knielsen/pcb_ledtorus_2/(list of files, drawings)

Other design files:
pcb_ledtorus_2.dsn
