knielsen/pcb_ledtorus_2/pcb_ledtorus_2.kicad_pcb

## KiCad design pcb_ledtorus_2.kicad_pcb (2016-04-10)

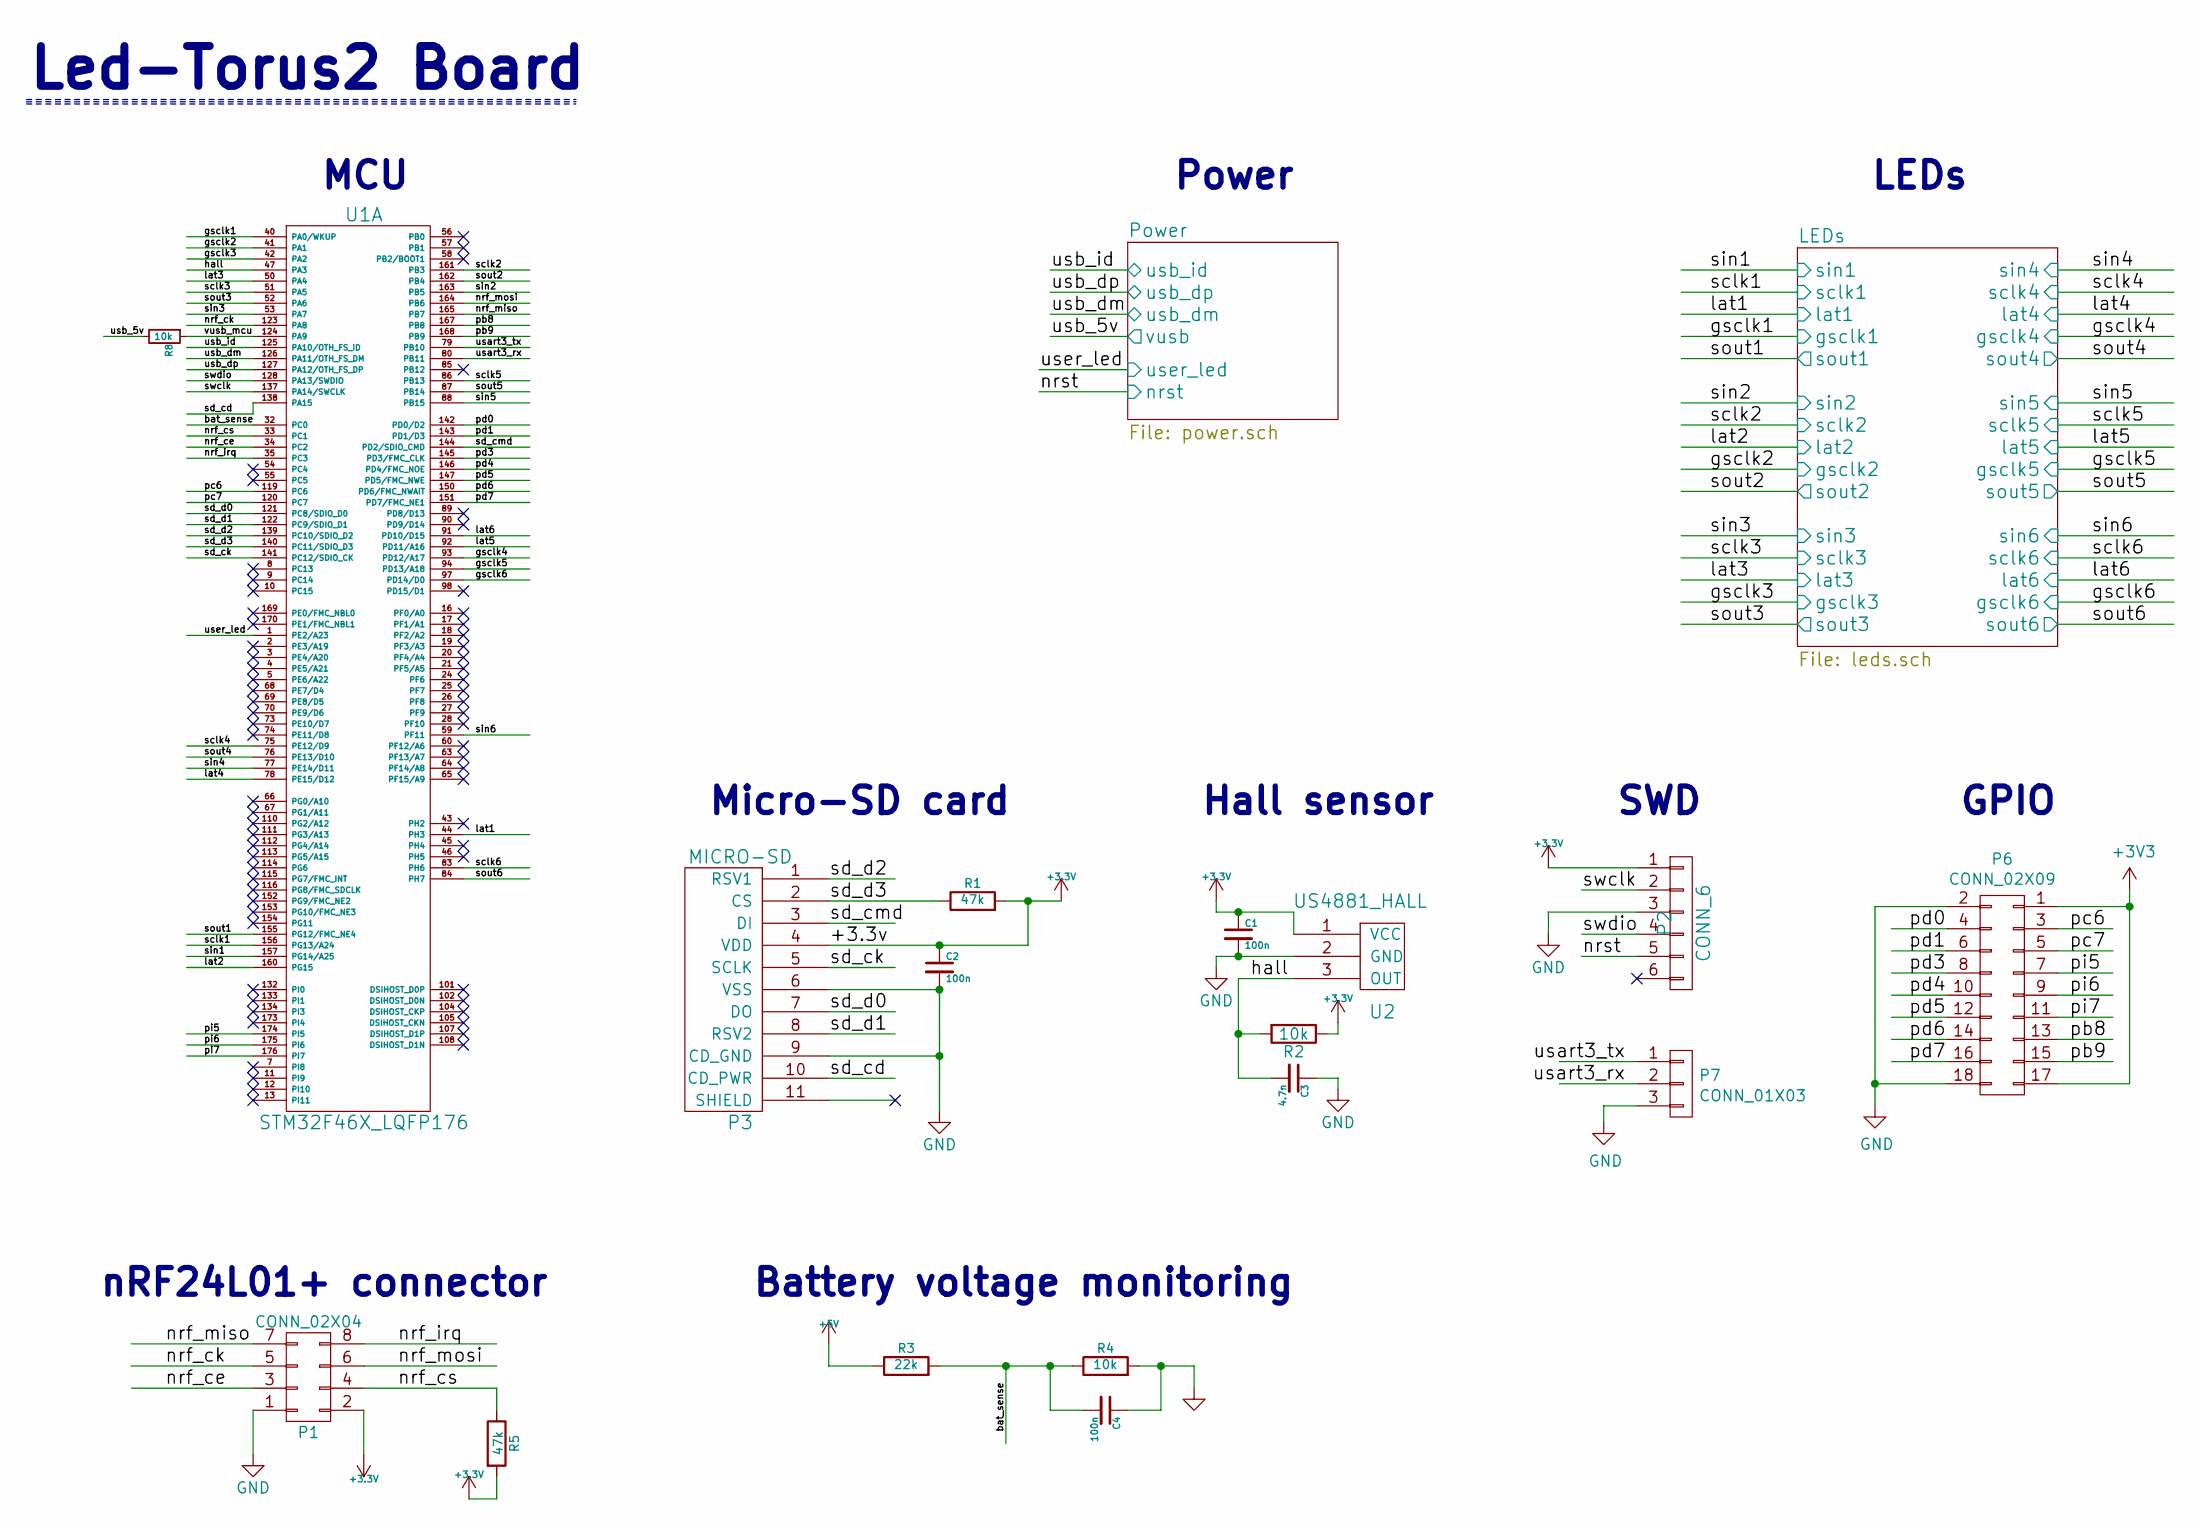
[picture p1: schematic pcb_ledtorus_2.sch]

Parts:
C1, C2, C4: 100n; c_0603
C3: 4.7n; c_0805
P1: CONN_02X04; pin_socket_4x2
P2: CONN_6; pin_strip_6
P3: MICRO-SD; SD_502774
P6: CONN_02X09; Pin_Header_Straight_2x09
P7: CONN_01X03; Pin_Header_Straight_1x03
R1, R5: 47k; r_0805
R2, R4, R8: 10k; r_0805
R3: 22k; r_0805
U1: STM32F46X_LQFP176; LQFP-176
U2: US4881_HALL; TO-92_Inline_Narrow_Oval

Connections:
+5V: R3.1; also elsewhere on the board
/bat_sense: C4.2, R3.2, R4.1, U1.32 (PC0)
/gsclk1: U1.40 (PA0/WKUP); also elsewhere on the board
/gsclk2: U1.41 (PA1); also elsewhere on the board
/gsclk3: U1.42 (PA2); also elsewhere on the board
/gsclk4: U1.93 (PD12/A17); also elsewhere on the board
/gsclk5: U1.94 (PD13/A18); also elsewhere on the board
/gsclk6: U1.97 (PD14/D0); also elsewhere on the board
/hall: C3.2, R2.2, U1.47 (PA3), U2.3 (OUT)
/lat1: U1.44 (PH3); also elsewhere on the board
/lat2: U1.160 (PG15); also elsewhere on the board
/lat3: U1.50 (PA4); also elsewhere on the board
/lat4: U1.78 (PE15/D12); also elsewhere on the board
/lat5: U1.92 (PD11/A16); also elsewhere on the board
/lat6: U1.91 (PD10/D15); also elsewhere on the board
/nrf_ce: P1.3, U1.34 (PC2)
/nrf_ck: P1.5, U1.123 (PA8)
/nrf_cs: P1.4, R5.1, U1.33 (PC1)
/nrf_irq: P1.8, U1.35 (PC3)
/nrf_miso: P1.7, U1.165 (PB7)
/nrf_mosi: P1.6, U1.164 (PB6)
/nrst: P2.5; also elsewhere on the board
/pb8: P6.13, U1.167 (PB8)
/pb9: P6.15, U1.168 (PB9)
/pc6: P6.3, U1.119 (PC6)
/pc7: P6.5, U1.120 (PC7)
/pd0: P6.4, U1.142 (PD0/D2)
/pd1: P6.6, U1.143 (PD1/D3)
/pd3: P6.8, U1.145 (PD3/FMC_CLK)
/pd4: P6.10, U1.146 (PD4/FMC_NOE)
/pd5: P6.12, U1.147 (PD5/FMC_NWE)
/pd6: P6.14, U1.150 (PD6/FMC_NWAIT)
/pd7: P6.16, U1.151 (PD7/FMC_NE1)
/pi5: P6.7, U1.174 (PI5)
/pi6: P6.9, U1.175 (PI6)
/pi7: P6.11, U1.176 (PI7)
/sclk1: U1.156 (PG13/A24); also elsewhere on the board
/sclk2: U1.161 (PB3); also elsewhere on the board
/sclk3: U1.51 (PA5); also elsewhere on the board
/sclk4: U1.75 (PE12/D9); also elsewhere on the board
/sclk5: U1.86 (PB13); also elsewhere on the board
/sclk6: U1.83 (PH6); also elsewhere on the board
/sd_cd: P3.10 (CD_PWR), U1.138 (PA15)
/sd_ck: P3.5 (SCLK), U1.141 (PC12/SDIO_CK)
/sd_cmd: P3.3 (DI), U1.144 (PD2/SDIO_CMD)
/sd_d0: P3.7 (DO), U1.121 (PC8/SDIO_D0)
/sd_d1: P3.8 (RSV2), U1.122 (PC9/SDIO_D1)
/sd_d2: P3.1 (RSV1), U1.139 (PC10/SDIO_D2)
/sd_d3: P3.2 (CS), R1.1, U1.140 (PC11/SDIO_D3)
/sin1: U1.157 (PG14/A25); also elsewhere on the board
/sin2: U1.163 (PB5); also elsewhere on the board
/sin3: U1.53 (PA7); also elsewhere on the board
/sin4: U1.77 (PE14/D11); also elsewhere on the board
/sin5: U1.88 (PB15); also elsewhere on the board
/sin6: U1.59 (PF11); also elsewhere on the board
/sout1: U1.155 (PG12/FMC_NE4); also elsewhere on the board
/sout2: U1.162 (PB4); also elsewhere on the board
/sout3: U1.52 (PA6); also elsewhere on the board
/sout4: U1.76 (PE13/D10); also elsewhere on the board
/sout5: U1.87 (PB14); also elsewhere on the board
/sout6: U1.84 (PH7); also elsewhere on the board
/swclk: P2.2, U1.137 (PA14/SWCLK)
/swdio: P2.4, U1.128 (PA13/SWDIO)
/usart3_rx: P7.2, U1.80 (PB11)
/usart3_tx: P7.1, U1.79 (PB10)
/usb_5v: R8.2; also elsewhere on the board
/usb_dm: U1.126 (PA11/OTH_FS_DM); also elsewhere on the board
/usb_dp: U1.127 (PA12/OTH_FS_DP); also elsewhere on the board
/usb_id: U1.125 (PA10/OTH_FS_ID); also elsewhere on the board
/user_led: U1.1 (PE2/A23); also elsewhere on the board
/vusb_mcu: R8.1, U1.124 (PA9)
GND: C1.2, C2.2, C3.1, C4.1, P1.1, P2.3, P3.6 (VSS), P3.9 (CD_GND), P6.2, P6.18, P7.3, R4.2, U2.2 (GND); also elsewhere on the board

Notes on the sheet:
MCU
Led-Torus2 Board
nRF24L01+ connector
Micro-SD card
Battery voltage monitoring
SWD
Hall sensor
GPIO
Power
LEDs

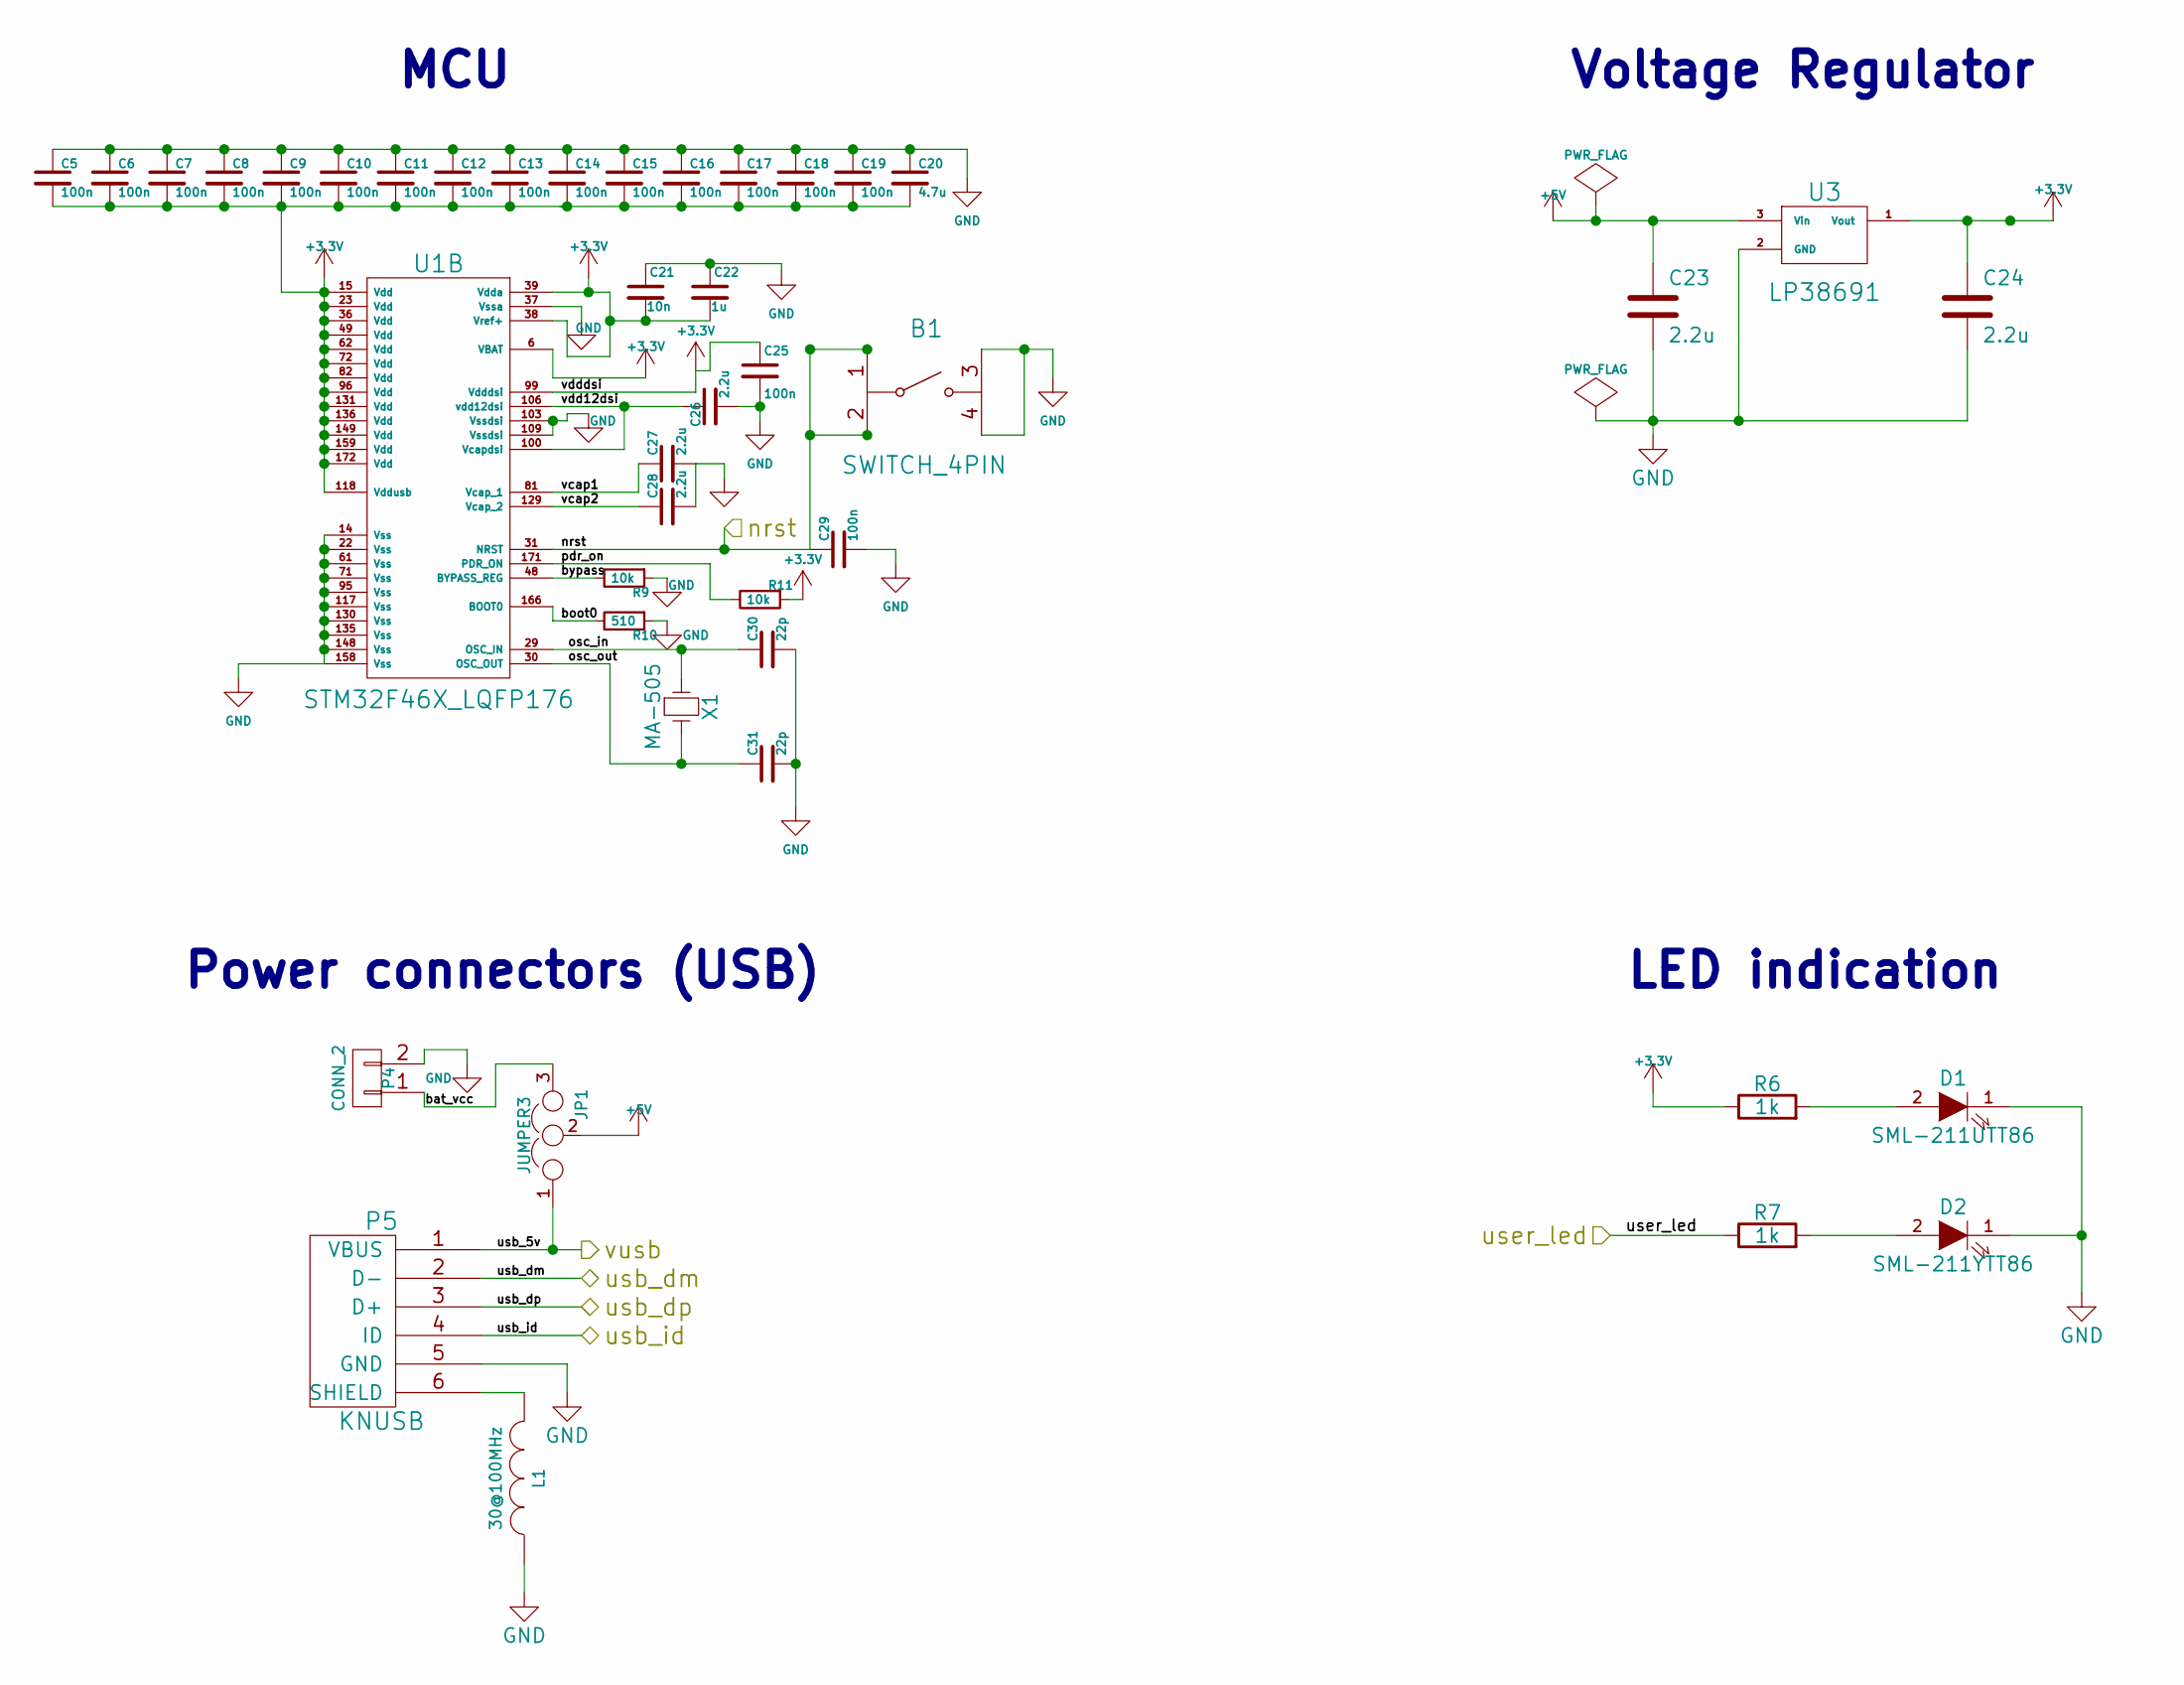
[picture p2: schematic power.sch]

Parts:
B1: SWITCH_4PIN; SWITCH_FSMJSMA
C5, C6, C7, C8, C9, C10, C11, C12, C13, C14, C15, C16, C17, C18, C19, C25, C29: 100n; c_0603
C20: 4.7u; c_0805
C21: 10n; c_0805
C22: 1u; c_0805
C23, C24, C26, C27, C28: 2.2u; c_0805
C30, C31: 22p; c_0805
D1: SML-211UTT86; LED_0805
D2: SML-211YTT86; LED_0805
JP1: JUMPER3; pin_strip_3
L1: 30@100MHz; c_0603
P4: CONN_2; pin_strip_2-90
P5: KNUSB; 10103594-0001LF
R6, R7: 1k; r_0805
R9, R11: 10k; r_0805
R10: 510; r_0805
U1: STM32F46X_LQFP176; LQFP-176
U3: LP38691; TO-252-3
X1: MA-505; 2-SOJ

Connections:
+5V: C23.1, JP1.2, U3.3 (Vin); also elsewhere on the board
/Power/bat_vcc: JP1.3, P4.1
/Power/boot0: R10.2, U1.166 (BOOT0)
/Power/bypass: R9.2, U1.48 (BYPASS_REG)
/Power/osc_in: C30.1, U1.29 (OSC_IN), X1.1
/Power/osc_out: C31.1, U1.30 (OSC_OUT), X1.2
/Power/pdr_on: R11.2, U1.171 (PDR_ON)
/Power/vcap1: C27.1, U1.81 (Vcap_1)
/Power/vcap2: C28.1, U1.129 (Vcap_2)
/Power/vdd12dsi: C26.1, U1.100 (Vcapdsi), U1.106 (vdd12dsi)
/nrst: B1.1, B1.2, C29.1, U1.31 (NRST); also elsewhere on the board
/usb_5v: JP1.1, P5.1 (VBUS); also elsewhere on the board
/usb_dm: P5.2 (D-); also elsewhere on the board
/usb_dp: P5.3 (D+); also elsewhere on the board
/usb_id: P5.4 (ID); also elsewhere on the board
/user_led: R7.1; also elsewhere on the board
GND: B1.3, B1.4, C5.1, C6.1, C7.1, C8.1, C9.1, C10.1, C11.1, C12.1, C13.1, C14.1, C15.1, C16.1, C17.1, C18.1, C19.1, C20.1, C21.1, C22.1, C23.2, C24.2, C25.2, C26.2, C27.2, C28.2, C29.2, C30.2, C31.2, D1.1 (K), D2.1 (K), L1.1, P4.2, P5.5 (GND), R9.1, R10.1, U1.14 (Vss), U1.22 (Vss), U1.37 (Vssa), U1.61 (Vss), U1.71 (Vss), U1.95 (Vss), U1.103 (Vssdsi), U1.109 (Vssdsi), U1.117 (Vss), U1.130 (Vss), U1.135 (Vss), U1.148 (Vss), U1.158 (Vss), U3.2 (GND); also elsewhere on the board
unnamed: D1.2 (A), R6.2
unnamed: D2.2 (A), R7.2
unnamed: L1.2, P5.6 (SHIELD)

Notes on the sheet:
MCU
Voltage Regulator
Power connectors (USB)
LED indication
