knielsen/pcb_ledtorus_2/pcb_ledtorus_2.kicad_pcb

## KiCad design pcb_ledtorus_2.kicad_pcb (continued)

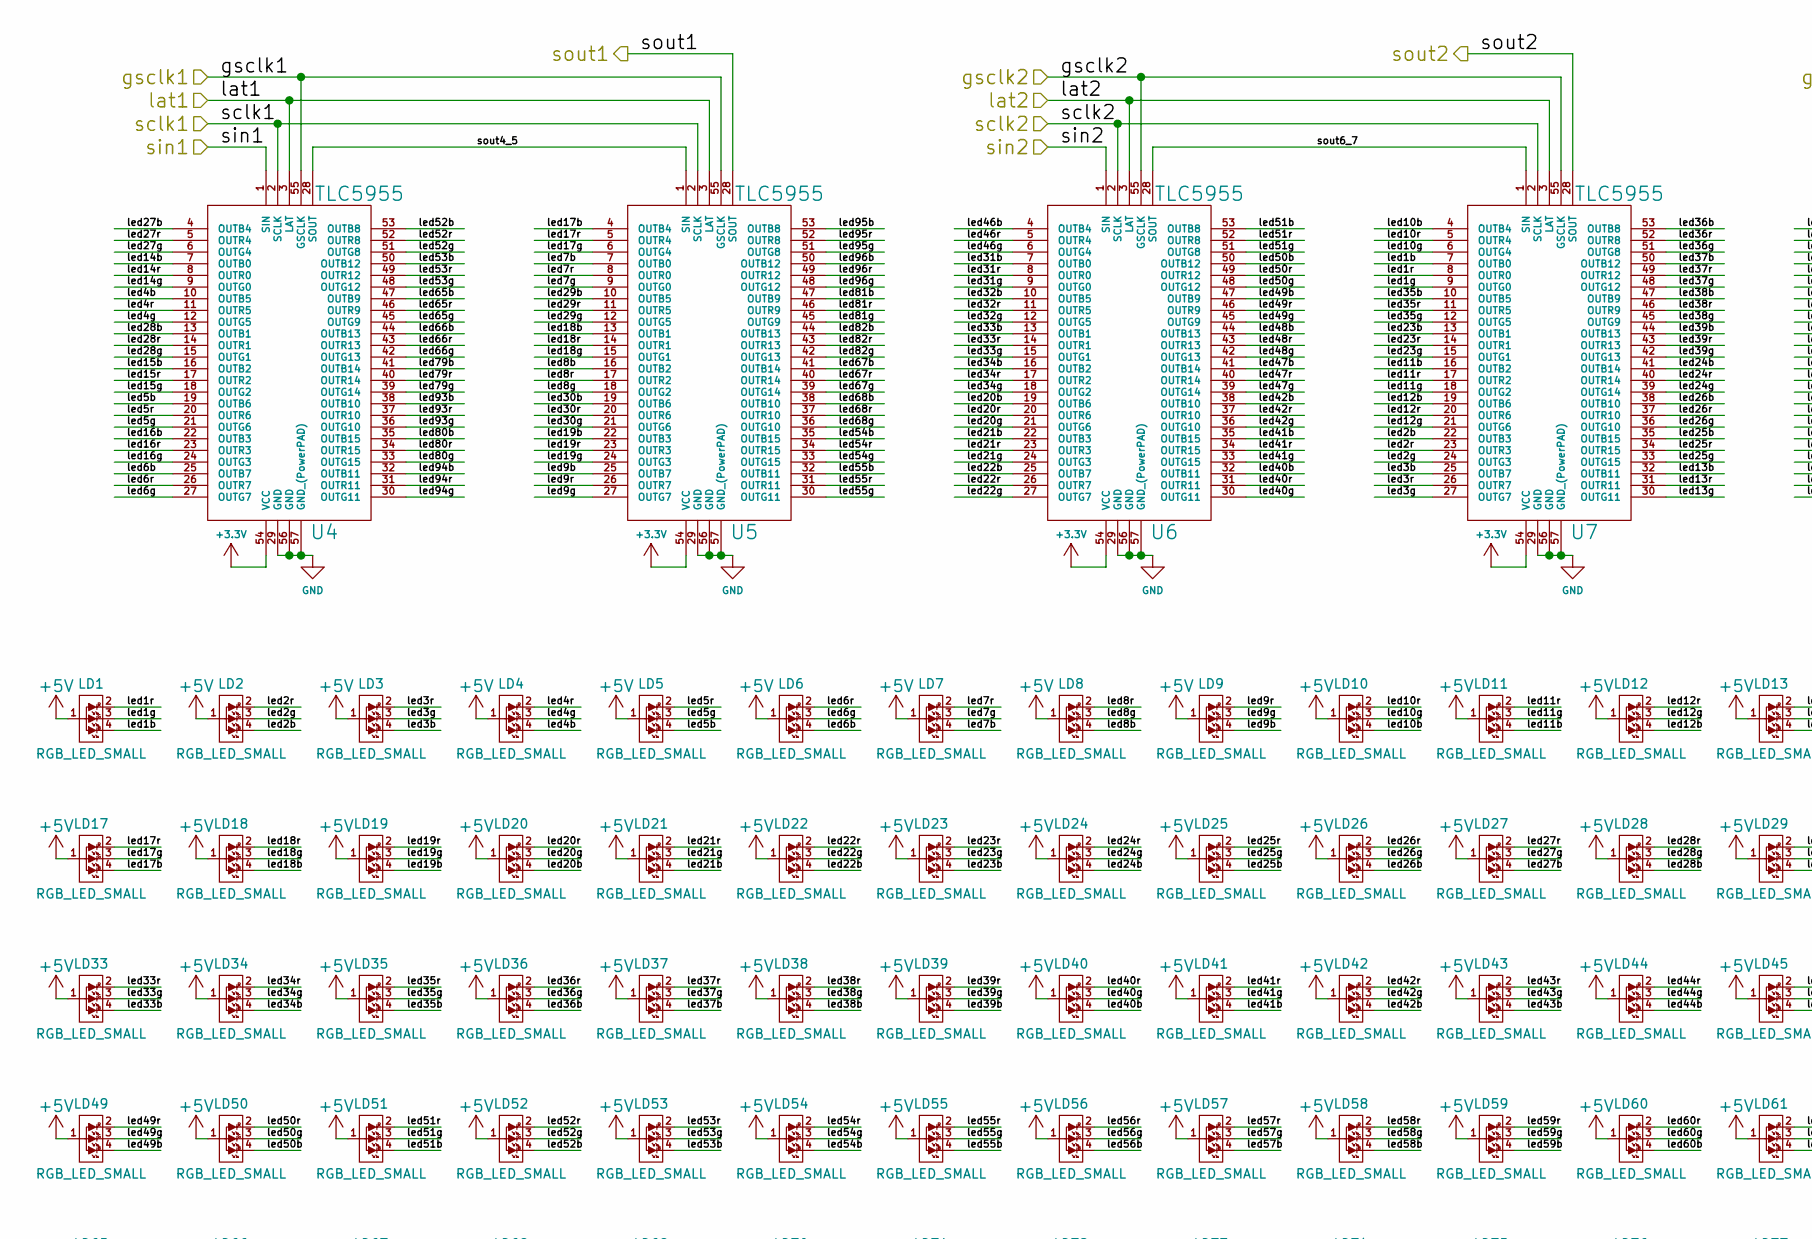
[picture p3: schematic leds.sch, part in row 1, column 1]

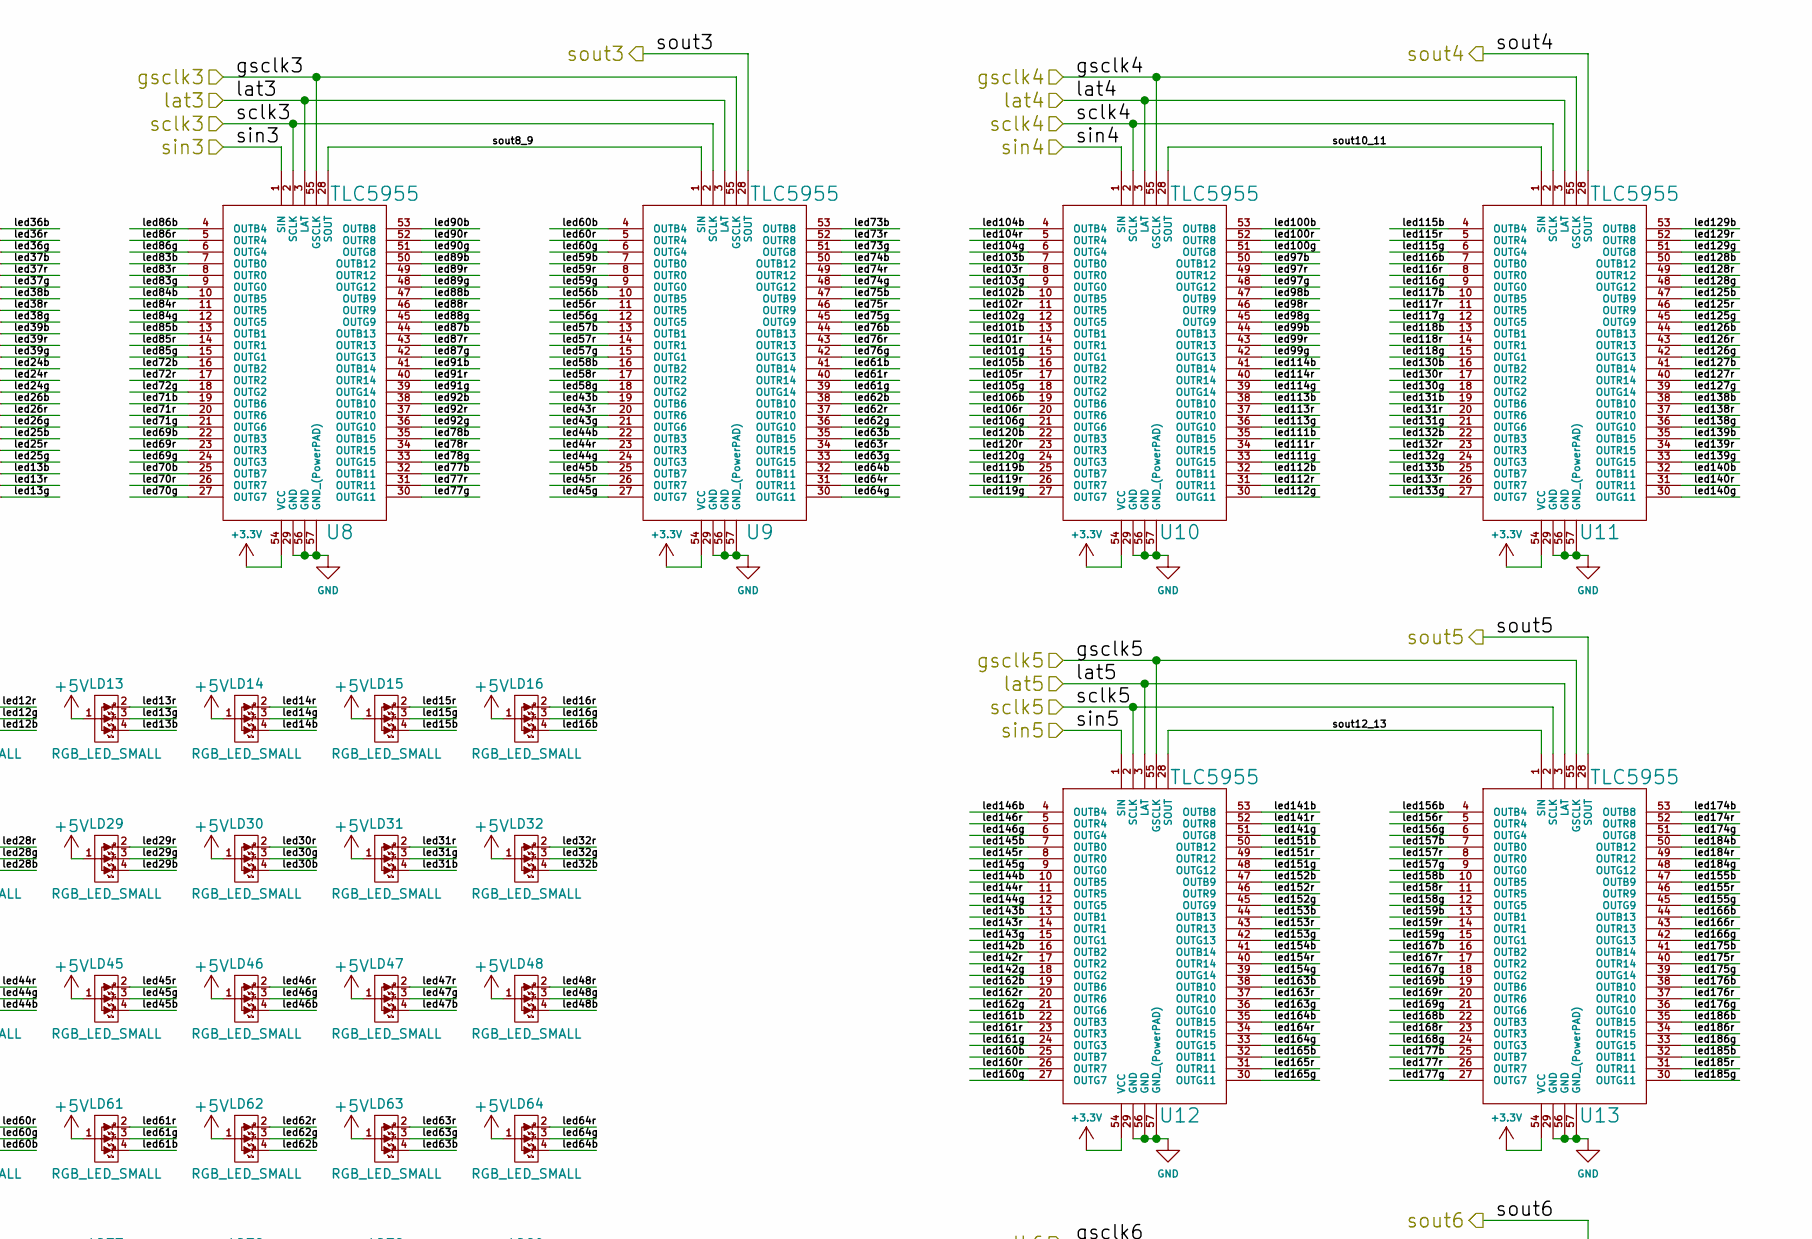
[picture p4: schematic leds.sch, part in row 1, column 2]

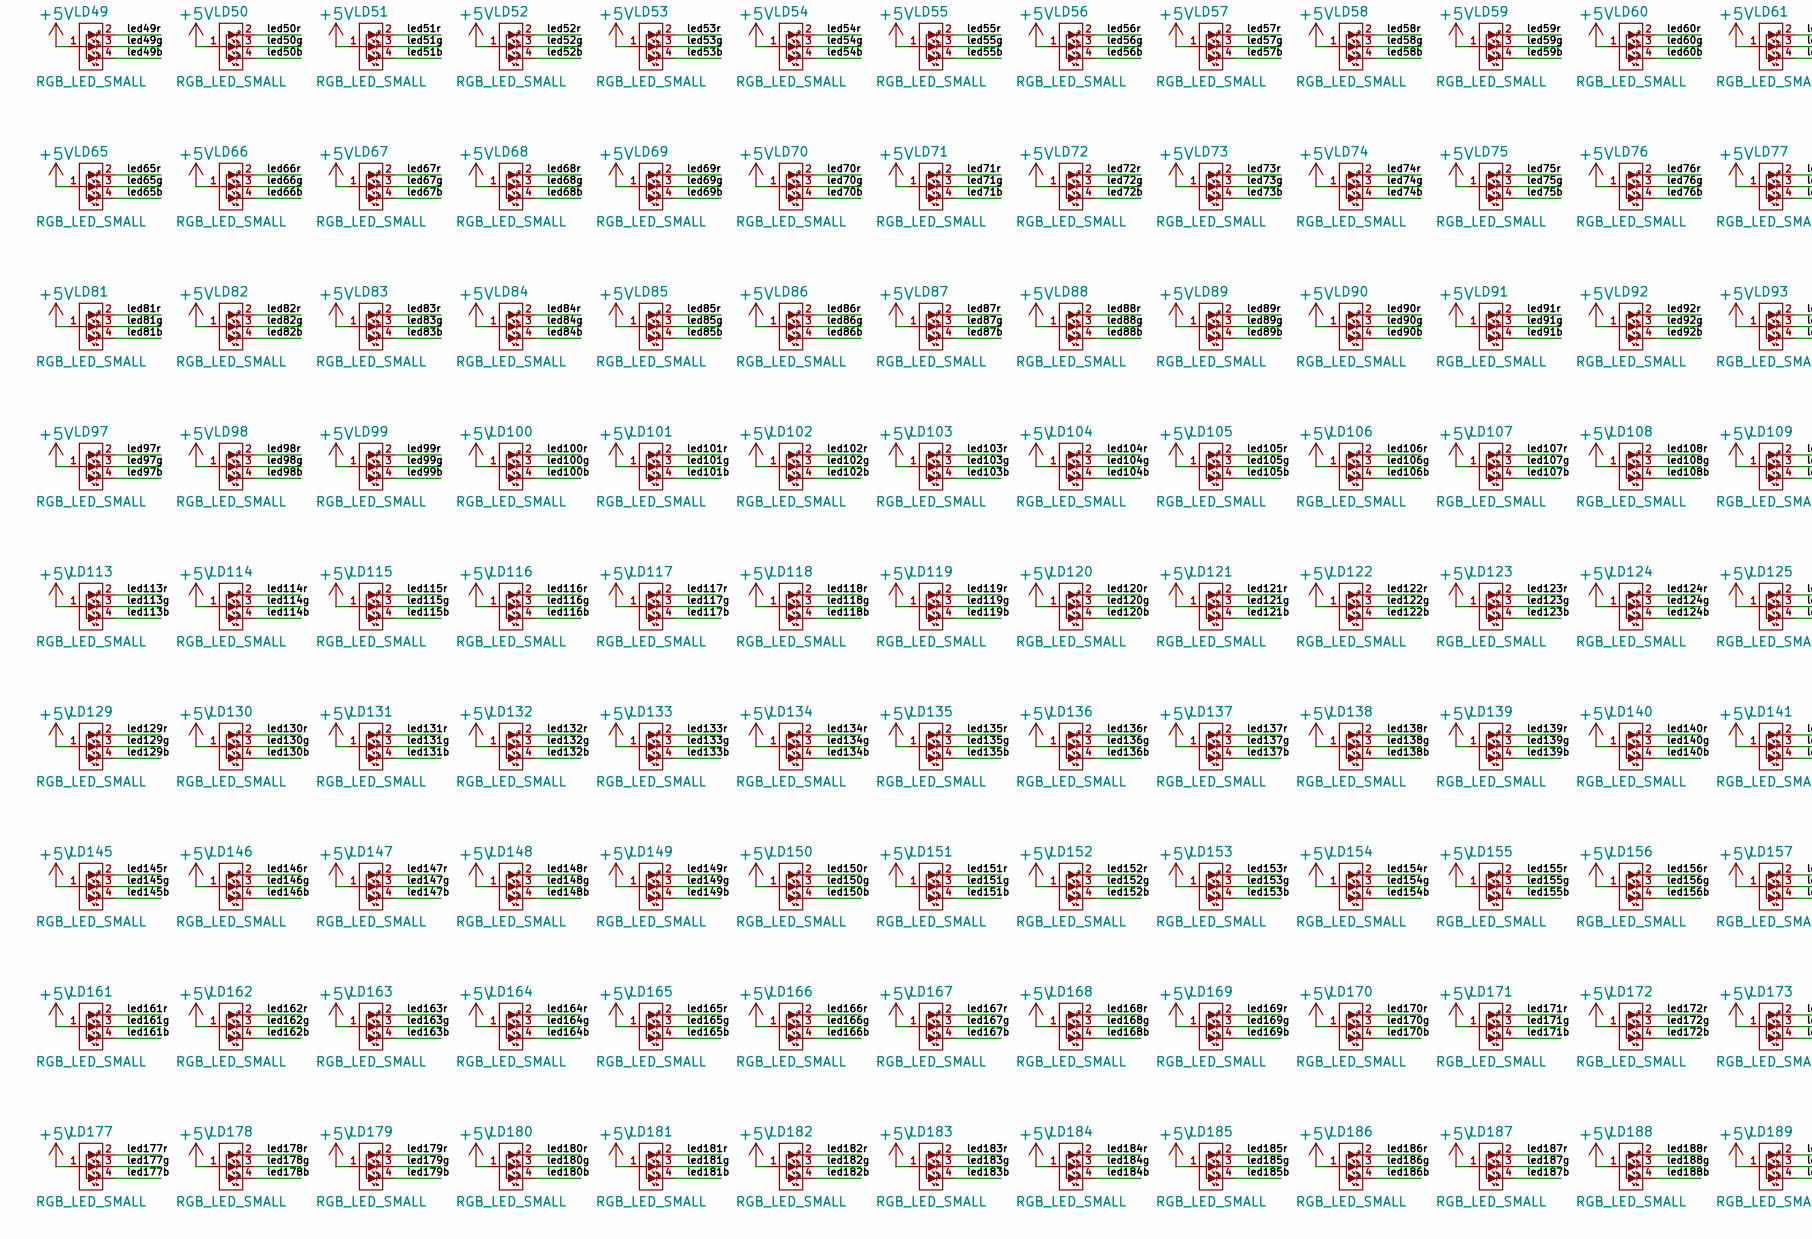
[picture p5: schematic leds.sch, part in row 2, column 1]

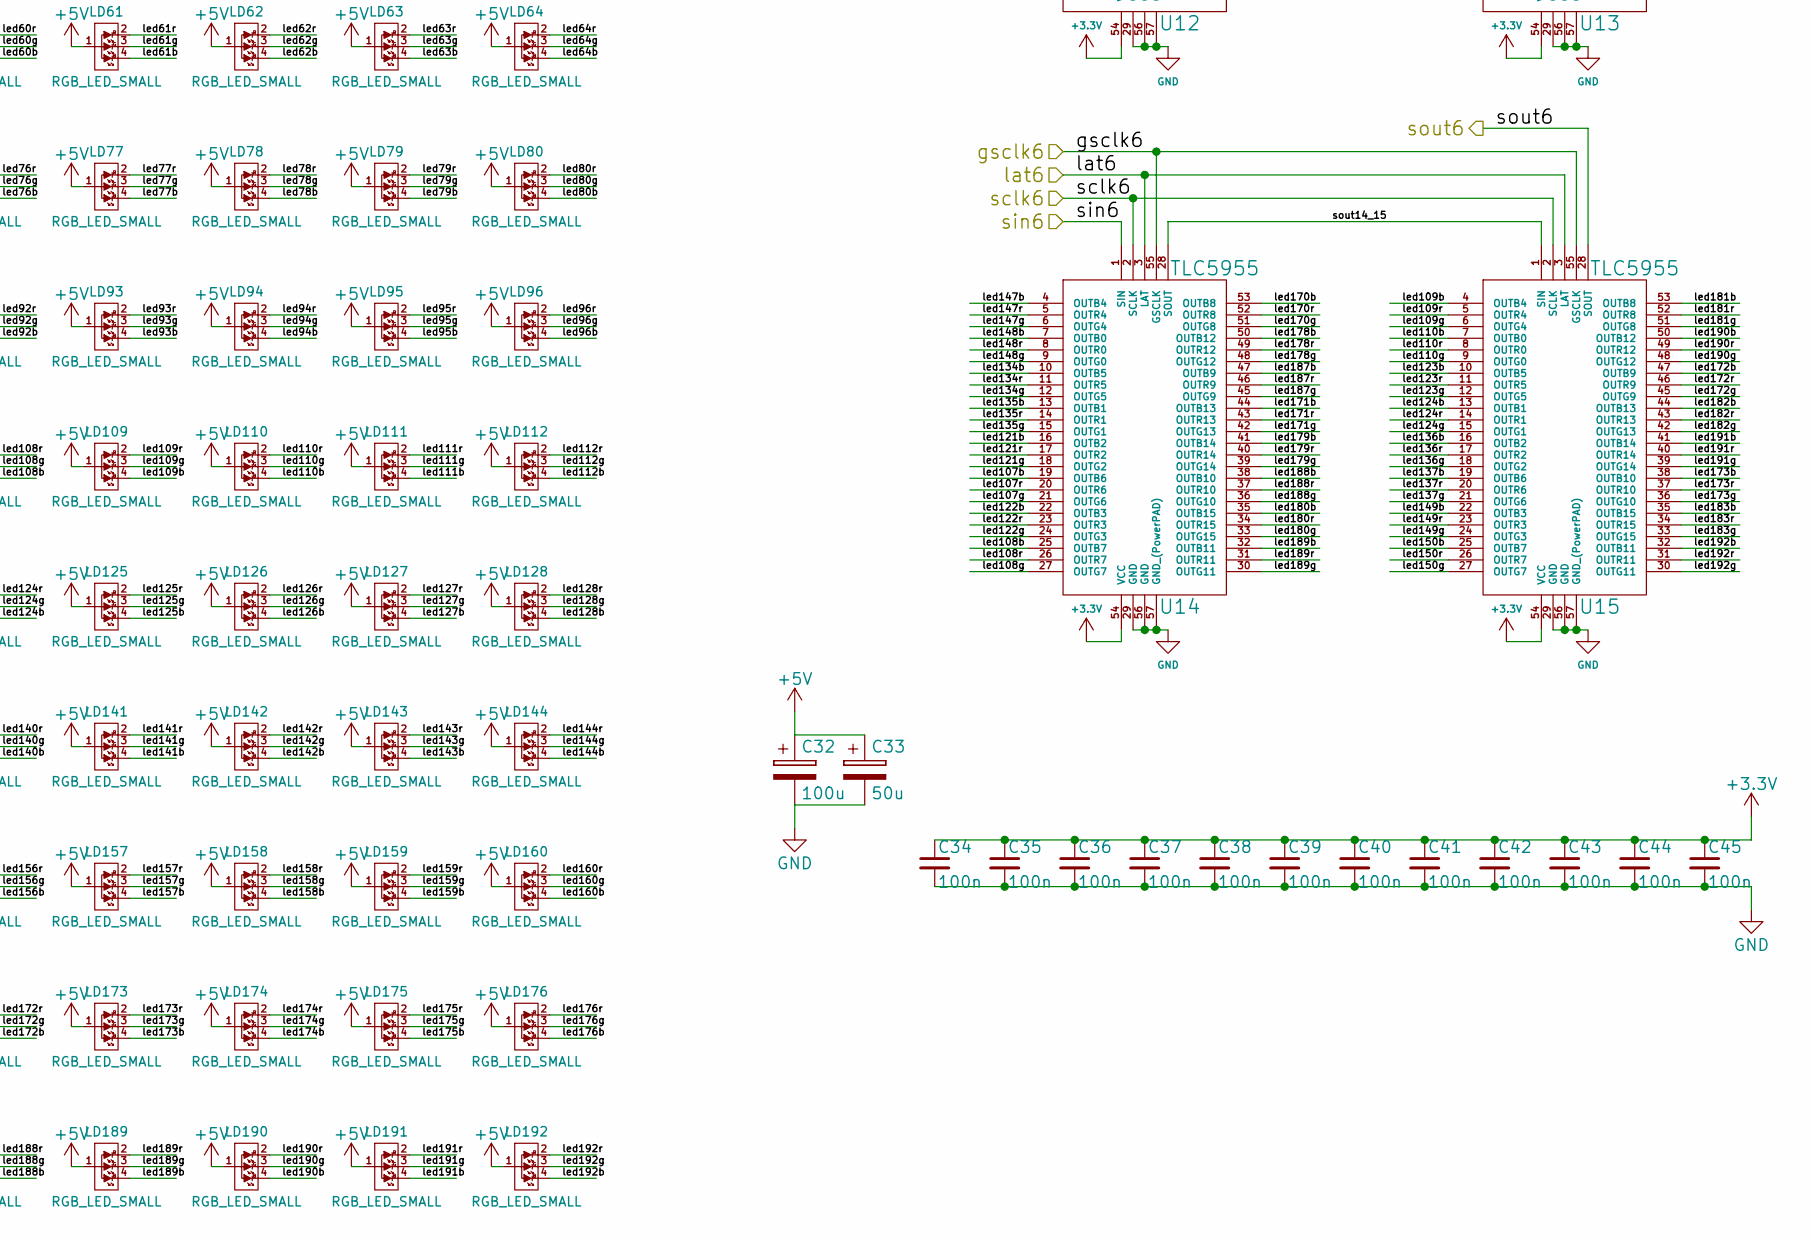
[picture p6: schematic leds.sch, part in row 2, column 2]

Parts:
C32: 100u; c_elec_6.3x5.8
C33: 50u; c_elec_6.3x5.8
C34, C35, C36, C37, C38, C39, C40, C41, C42, C43, C44, C45: 100n; c_0603
LD1, LD2, LD3, LD4, LD5, LD6, LD7, LD8, LD9, LD10, LD11, LD12, LD13, LD14, LD15, LD16, LD17, LD18, LD19, LD20, LD21, LD22, LD23, LD24, LD25, LD26, LD27, LD28, LD29, LD30, LD31, LD32, LD33, LD34, LD35, LD36, LD37, LD38, LD39, LD40, LD41, LD42, LD43, LD44, LD45, LD46, LD47, LD48, LD49, LD50, LD51, LD52, LD53, LD54, LD55, LD56, LD57, LD58, LD59, LD60, LD61, LD62, LD63, LD64, LD65, LD66, LD67, LD68, LD69, LD70, LD71, LD72, LD73, LD74, LD75, LD76, LD77, LD78, LD79, LD80, LD81, LD82, LD83, LD84, LD85, LD86, LD87, LD88, LD89, LD90, LD91, LD92, LD93, LD94, LD95, LD96, LD97, LD98, LD99, LD100, LD101, LD102, LD103, LD104, LD105, LD106, LD107, LD108, LD109, LD110, LD111, LD112, LD113, LD114, LD115, LD116, LD117, LD118, LD119, LD120, LD121, LD122, LD123, LD124, LD125, LD126, LD127, LD128, LD129, LD130, LD131, LD132, LD133, LD134, LD135, LD136, LD137, LD138, LD139, LD140, LD141, LD142, LD143, LD144, LD145, LD146, LD147, LD148, LD149, LD150, LD151, LD152, LD153, LD154, LD155, LD156, LD157, LD158, LD159, LD160, LD161, LD162, LD163, LD164, LD165, LD166, LD167, LD168, LD169, LD170, LD171, LD172, LD173, LD174, LD175, LD176, LD177, LD178, LD179, LD180, LD181, LD182, LD183, LD184, LD185, LD186, LD187, LD188, LD189, LD190, LD191, LD192: RGB_LED_SMALL; RGB_0603
U4, U5, U6, U7, U8, U9, U10, U11, U12, U13, U14, U15: TLC5955; TLC5955DCA

Connections:
+5V: C32.1, C33.1, LD1.1 (AG), LD2.1 (AG), LD3.1 (AG), LD4.1 (AG), LD5.1 (AG), LD6.1 (AG), LD7.1 (AG), LD8.1 (AG), LD9.1 (AG), LD10.1 (AG), LD11.1 (AG), LD12.1 (AG), LD13.1 (AG), LD14.1 (AG), LD15.1 (AG), LD16.1 (AG), LD17.1 (AG), LD18.1 (AG), LD19.1 (AG), LD20.1 (AG), LD21.1 (AG), LD22.1 (AG), LD23.1 (AG), LD24.1 (AG), LD25.1 (AG), LD26.1 (AG), LD27.1 (AG), LD28.1 (AG), LD29.1 (AG), LD30.1 (AG), LD31.1 (AG), LD32.1 (AG), LD33.1 (AG), LD34.1 (AG), LD35.1 (AG), LD36.1 (AG), LD37.1 (AG), LD38.1 (AG), LD39.1 (AG), LD40.1 (AG), LD41.1 (AG), LD42.1 (AG), LD43.1 (AG), LD44.1 (AG), LD45.1 (AG), LD46.1 (AG), LD47.1 (AG), LD48.1 (AG), LD49.1 (AG), LD50.1 (AG), LD51.1 (AG), LD52.1 (AG), LD53.1 (AG), LD54.1 (AG), LD55.1 (AG), LD56.1 (AG), LD57.1 (AG), LD58.1 (AG), LD59.1 (AG), LD60.1 (AG), LD61.1 (AG), LD62.1 (AG), LD63.1 (AG), LD64.1 (AG), LD65.1 (AG), LD66.1 (AG), LD67.1 (AG), LD68.1 (AG), LD69.1 (AG), LD70.1 (AG), LD71.1 (AG), LD72.1 (AG), LD73.1 (AG), LD74.1 (AG), LD75.1 (AG), LD76.1 (AG), LD77.1 (AG), LD78.1 (AG), LD79.1 (AG), LD80.1 (AG), LD81.1 (AG), LD82.1 (AG), LD83.1 (AG), LD84.1 (AG), LD85.1 (AG), LD86.1 (AG), LD87.1 (AG), LD88.1 (AG), LD89.1 (AG), LD90.1 (AG), LD91.1 (AG), LD92.1 (AG), LD93.1 (AG), LD94.1 (AG), LD95.1 (AG), LD96.1 (AG), LD97.1 (AG), LD98.1 (AG), LD99.1 (AG), LD100.1 (AG), LD101.1 (AG), LD102.1 (AG), LD103.1 (AG), LD104.1 (AG), LD105.1 (AG), LD106.1 (AG), LD107.1 (AG), LD108.1 (AG), LD109.1 (AG), LD110.1 (AG), LD111.1 (AG), LD112.1 (AG), LD113.1 (AG), LD114.1 (AG), LD115.1 (AG), LD116.1 (AG), LD117.1 (AG), LD118.1 (AG), LD119.1 (AG), LD120.1 (AG), LD121.1 (AG), LD122.1 (AG), LD123.1 (AG), LD124.1 (AG), LD125.1 (AG), LD126.1 (AG), LD127.1 (AG), LD128.1 (AG), LD129.1 (AG), LD130.1 (AG), LD131.1 (AG), LD132.1 (AG), LD133.1 (AG), LD134.1 (AG), LD135.1 (AG), LD136.1 (AG), LD137.1 (AG), LD138.1 (AG), LD139.1 (AG), LD140.1 (AG), LD141.1 (AG), LD142.1 (AG), LD143.1 (AG), LD144.1 (AG), LD145.1 (AG), LD146.1 (AG), LD147.1 (AG), LD148.1 (AG), LD149.1 (AG), LD150.1 (AG), LD151.1 (AG), LD152.1 (AG), LD153.1 (AG), LD154.1 (AG), LD155.1 (AG), LD156.1 (AG), LD157.1 (AG), LD158.1 (AG), LD159.1 (AG), LD160.1 (AG), LD161.1 (AG), LD162.1 (AG), LD163.1 (AG), LD164.1 (AG), LD165.1 (AG), LD166.1 (AG), LD167.1 (AG), LD168.1 (AG), LD169.1 (AG), LD170.1 (AG), LD171.1 (AG), LD172.1 (AG), LD173.1 (AG), LD174.1 (AG), LD175.1 (AG), LD176.1 (AG), LD177.1 (AG), LD178.1 (AG), LD179.1 (AG), LD180.1 (AG), LD181.1 (AG), LD182.1 (AG), LD183.1 (AG), LD184.1 (AG), LD185.1 (AG), LD186.1 (AG), LD187.1 (AG), LD188.1 (AG), LD189.1 (AG), LD190.1 (AG), LD191.1 (AG), LD192.1 (AG); also elsewhere on the board
/LEDs/led1b: LD1.4 (R), U7.7 (OUTB0)
/LEDs/led1g: LD1.3 (R), U7.9 (OUTG0)
/LEDs/led1r: LD1.2 (R), U7.8 (OUTR0)
/LEDs/led2b: LD2.4 (R), U7.22 (OUTB3)
/LEDs/led2g: LD2.3 (R), U7.24 (OUTG3)
/LEDs/led2r: LD2.2 (R), U7.23 (OUTR3)
/LEDs/led3b: LD3.4 (R), U7.25 (OUTB7)
/LEDs/led3g: LD3.3 (R), U7.27 (OUTG7)
/LEDs/led3r: LD3.2 (R), U7.26 (OUTR7)
/LEDs/led4b: LD4.4 (R), U4.10 (OUTB5)
/LEDs/led4g: LD4.3 (R), U4.12 (OUTG5)
/LEDs/led4r: LD4.2 (R), U4.11 (OUTR5)
/LEDs/led5b: LD5.4 (R), U4.19 (OUTB6)
/LEDs/led5g: LD5.3 (R), U4.21 (OUTG6)
/LEDs/led5r: LD5.2 (R), U4.20 (OUTR6)
/LEDs/led6b: LD6.4 (R), U4.25 (OUTB7)
/LEDs/led6g: LD6.3 (R), U4.27 (OUTG7)
/LEDs/led6r: LD6.2 (R), U4.26 (OUTR7)
/LEDs/led7b: LD7.4 (R), U5.7 (OUTB0)
/LEDs/led7g: LD7.3 (R), U5.9 (OUTG0)
/LEDs/led7r: LD7.2 (R), U5.8 (OUTR0)
/LEDs/led8b: LD8.4 (R), U5.16 (OUTB2)
/LEDs/led8g: LD8.3 (R), U5.18 (OUTG2)
/LEDs/led8r: LD8.2 (R), U5.17 (OUTR2)
/LEDs/led9b: LD9.4 (R), U5.25 (OUTB7)
/LEDs/led9g: LD9.3 (R), U5.27 (OUTG7)
/LEDs/led9r: LD9.2 (R), U5.26 (OUTR7)
/LEDs/led10b: LD10.4 (R), U7.4 (OUTB4)
/LEDs/led10g: LD10.3 (R), U7.6 (OUTG4)
/LEDs/led10r: LD10.2 (R), U7.5 (OUTR4)
/LEDs/led11b: LD11.4 (R), U7.16 (OUTB2)
/LEDs/led11g: LD11.3 (R), U7.18 (OUTG2)
/LEDs/led11r: LD11.2 (R), U7.17 (OUTR2)
/LEDs/led12b: LD12.4 (R), U7.19 (OUTB6)
/LEDs/led12g: LD12.3 (R), U7.21 (OUTG6)
/LEDs/led12r: LD12.2 (R), U7.20 (OUTR6)
/LEDs/led13b: LD13.4 (R), U7.32 (OUTB11)
/LEDs/led13g: LD13.3 (R), U7.30 (OUTG11)
/LEDs/led13r: LD13.2 (R), U7.31 (OUTR11)
/LEDs/led14b: LD14.4 (R), U4.7 (OUTB0)
/LEDs/led14g: LD14.3 (R), U4.9 (OUTG0)
/LEDs/led14r: LD14.2 (R), U4.8 (OUTR0)
/LEDs/led15b: LD15.4 (R), U4.16 (OUTB2)
/LEDs/led15g: LD15.3 (R), U4.18 (OUTG2)
/LEDs/led15r: LD15.2 (R), U4.17 (OUTR2)
/LEDs/led16b: LD16.4 (R), U4.22 (OUTB3)
/LEDs/led16g: LD16.3 (R), U4.24 (OUTG3)
/LEDs/led16r: LD16.2 (R), U4.23 (OUTR3)
/LEDs/led17b: LD17.4 (R), U5.4 (OUTB4)
/LEDs/led17g: LD17.3 (R), U5.6 (OUTG4)
/LEDs/led17r: LD17.2 (R), U5.5 (OUTR4)
/LEDs/led18b: LD18.4 (R), U5.13 (OUTB1)
/LEDs/led18g: LD18.3 (R), U5.15 (OUTG1)
/LEDs/led18r: LD18.2 (R), U5.14 (OUTR1)
/LEDs/led19b: LD19.4 (R), U5.22 (OUTB3)
/LEDs/led19g: LD19.3 (R), U5.24 (OUTG3)
/LEDs/led19r: LD19.2 (R), U5.23 (OUTR3)
/LEDs/led20b: LD20.4 (R), U6.19 (OUTB6)
/LEDs/led20g: LD20.3 (R), U6.21 (OUTG6)
/LEDs/led20r: LD20.2 (R), U6.20 (OUTR6)
/LEDs/led21b: LD21.4 (R), U6.22 (OUTB3)
/LEDs/led21g: LD21.3 (R), U6.24 (OUTG3)
/LEDs/led21r: LD21.2 (R), U6.23 (OUTR3)
/LEDs/led22b: LD22.4 (R), U6.25 (OUTB7)
/LEDs/led22g: LD22.3 (R), U6.27 (OUTG7)
/LEDs/led22r: LD22.2 (R), U6.26 (OUTR7)
/LEDs/led23b: LD23.4 (R), U7.13 (OUTB1)
/LEDs/led23g: LD23.3 (R), U7.15 (OUTG1)
/LEDs/led23r: LD23.2 (R), U7.14 (OUTR1)
/LEDs/led24b: LD24.4 (R), U7.41 (OUTB14)
/LEDs/led24g: LD24.3 (R), U7.39 (OUTG14)
/LEDs/led24r: LD24.2 (R), U7.40 (OUTR14)
/LEDs/led25b: LD25.4 (R), U7.35 (OUTB15)
/LEDs/led25g: LD25.3 (R), U7.33 (OUTG15)
/LEDs/led25r: LD25.2 (R), U7.34 (OUTR15)
/LEDs/led26b: LD26.4 (R), U7.38 (OUTB10)
/LEDs/led26g: LD26.3 (R), U7.36 (OUTG10)
/LEDs/led26r: LD26.2 (R), U7.37 (OUTR10)
/LEDs/led27b: LD27.4 (R), U4.4 (OUTB4)
/LEDs/led27g: LD27.3 (R), U4.6 (OUTG4)
/LEDs/led27r: LD27.2 (R), U4.5 (OUTR4)
/LEDs/led28b: LD28.4 (R), U4.13 (OUTB1)
/LEDs/led28g: LD28.3 (R), U4.15 (OUTG1)
/LEDs/led28r: LD28.2 (R), U4.14 (OUTR1)
/LEDs/led29b: LD29.4 (R), U5.10 (OUTB5)
/LEDs/led29g: LD29.3 (R), U5.12 (OUTG5)
/LEDs/led29r: LD29.2 (R), U5.11 (OUTR5)
/LEDs/led30b: LD30.4 (R), U5.19 (OUTB6)
/LEDs/led30g: LD30.3 (R), U5.21 (OUTG6)
/LEDs/led30r: LD30.2 (R), U5.20 (OUTR6)
/LEDs/led31b: LD31.4 (R), U6.7 (OUTB0)
/LEDs/led31g: LD31.3 (R), U6.9 (OUTG0)
/LEDs/led31r: LD31.2 (R), U6.8 (OUTR0)
/LEDs/led32b: LD32.4 (R), U6.10 (OUTB5)
/LEDs/led32g: LD32.3 (R), U6.12 (OUTG5)
/LEDs/led32r: LD32.2 (R), U6.11 (OUTR5)
/LEDs/led33b: LD33.4 (R), U6.13 (OUTB1)
/LEDs/led33g: LD33.3 (R), U6.15 (OUTG1)
/LEDs/led33r: LD33.2 (R), U6.14 (OUTR1)
/LEDs/led34b: LD34.4 (R), U6.16 (OUTB2)
/LEDs/led34g: LD34.3 (R), U6.18 (OUTG2)
/LEDs/led34r: LD34.2 (R), U6.17 (OUTR2)
/LEDs/led35b: LD35.4 (R), U7.10 (OUTB5)
/LEDs/led35g: LD35.3 (R), U7.12 (OUTG5)
/LEDs/led35r: LD35.2 (R), U7.11 (OUTR5)
/LEDs/led36b: LD36.4 (R), U7.53 (OUTB8)
/LEDs/led36g: LD36.3 (R), U7.51 (OUTG8)
/LEDs/led36r: LD36.2 (R), U7.52 (OUTR8)
/LEDs/led37b: LD37.4 (R), U7.50 (OUTB12)
/LEDs/led37g: LD37.3 (R), U7.48 (OUTG12)
/LEDs/led37r: LD37.2 (R), U7.49 (OUTR12)
/LEDs/led38b: LD38.4 (R), U7.47 (OUTB9)
/LEDs/led38g: LD38.3 (R), U7.45 (OUTG9)
/LEDs/led38r: LD38.2 (R), U7.46 (OUTR9)
/LEDs/led39b: LD39.4 (R), U7.44 (OUTB13)
/LEDs/led39g: LD39.3 (R), U7.42 (OUTG13)
/LEDs/led39r: LD39.2 (R), U7.43 (OUTR13)
/LEDs/led40b: LD40.4 (R), U6.32 (OUTB11)
/LEDs/led40g: LD40.3 (R), U6.30 (OUTG11)
/LEDs/led40r: LD40.2 (R), U6.31 (OUTR11)
/LEDs/led41b: LD41.4 (R), U6.35 (OUTB15)
/LEDs/led41g: LD41.3 (R), U6.33 (OUTG15)
/LEDs/led41r: LD41.2 (R), U6.34 (OUTR15)
/LEDs/led42b: LD42.4 (R), U6.38 (OUTB10)
/LEDs/led42g: LD42.3 (R), U6.36 (OUTG10)
/LEDs/led42r: LD42.2 (R), U6.37 (OUTR10)
/LEDs/led43b: LD43.4 (R), U9.19 (OUTB6)
/LEDs/led43g: LD43.3 (R), U9.21 (OUTG6)
/LEDs/led43r: LD43.2 (R), U9.20 (OUTR6)
/LEDs/led44b: LD44.4 (R), U9.22 (OUTB3)
/LEDs/led44g: LD44.3 (R), U9.24 (OUTG3)
/LEDs/led44r: LD44.2 (R), U9.23 (OUTR3)
/LEDs/led45b: LD45.4 (R), U9.25 (OUTB7)
/LEDs/led45g: LD45.3 (R), U9.27 (OUTG7)
/LEDs/led45r: LD45.2 (R), U9.26 (OUTR7)
/LEDs/led46b: LD46.4 (R), U6.4 (OUTB4)
/LEDs/led46g: LD46.3 (R), U6.6 (OUTG4)
/LEDs/led46r: LD46.2 (R), U6.5 (OUTR4)
/LEDs/led47b: LD47.4 (R), U6.41 (OUTB14)
/LEDs/led47g: LD47.3 (R), U6.39 (OUTG14)
/LEDs/led47r: LD47.2 (R), U6.40 (OUTR14)
/LEDs/led48b: LD48.4 (R), U6.44 (OUTB13)
/LEDs/led48g: LD48.3 (R), U6.42 (OUTG13)
/LEDs/led48r: LD48.2 (R), U6.43 (OUTR13)
/LEDs/led49b: LD49.4 (R), U6.47 (OUTB9)
/LEDs/led49g: LD49.3 (R), U6.45 (OUTG9)
/LEDs/led49r: LD49.2 (R), U6.46 (OUTR9)
/LEDs/led50b: LD50.4 (R), U6.50 (OUTB12)
/LEDs/led50g: LD50.3 (R), U6.48 (OUTG12)
/LEDs/led50r: LD50.2 (R), U6.49 (OUTR12)
/LEDs/led51b: LD51.4 (R), U6.53 (OUTB8)
/LEDs/led51g: LD51.3 (R), U6.51 (OUTG8)
/LEDs/led51r: LD51.2 (R), U6.52 (OUTR8)
/LEDs/led52b: LD52.4 (R), U4.53 (OUTB8)
/LEDs/led52g: LD52.3 (R), U4.51 (OUTG8)
/LEDs/led52r: LD52.2 (R), U4.52 (OUTR8)
/LEDs/led53b: LD53.4 (R), U4.50 (OUTB12)
/LEDs/led53g: LD53.3 (R), U4.48 (OUTG12)
/LEDs/led53r: LD53.2 (R), U4.49 (OUTR12)
/LEDs/led54b: LD54.4 (R), U5.35 (OUTB15)
/LEDs/led54g: LD54.3 (R), U5.33 (OUTG15)
/LEDs/led54r: LD54.2 (R), U5.34 (OUTR15)
/LEDs/led55b: LD55.4 (R), U5.32 (OUTB11)
/LEDs/led55g: LD55.3 (R), U5.30 (OUTG11)
/LEDs/led55r: LD55.2 (R), U5.31 (OUTR11)
/LEDs/led56b: LD56.4 (R), U9.10 (OUTB5)
/LEDs/led56g: LD56.3 (R), U9.12 (OUTG5)
/LEDs/led56r: LD56.2 (R), U9.11 (OUTR5)
/LEDs/led57b: LD57.4 (R), U9.13 (OUTB1)
/LEDs/led57g: LD57.3 (R), U9.15 (OUTG1)
/LEDs/led57r: LD57.2 (R), U9.14 (OUTR1)
/LEDs/led58b: LD58.4 (R), U9.16 (OUTB2)
/LEDs/led58g: LD58.3 (R), U9.18 (OUTG2)
/LEDs/led58r: LD58.2 (R), U9.17 (OUTR2)
/LEDs/led59b: LD59.4 (R), U9.7 (OUTB0)
/LEDs/led59g: LD59.3 (R), U9.9 (OUTG0)
/LEDs/led59r: LD59.2 (R), U9.8 (OUTR0)
/LEDs/led60b: LD60.4 (R), U9.4 (OUTB4)
/LEDs/led60g: LD60.3 (R), U9.6 (OUTG4)
/LEDs/led60r: LD60.2 (R), U9.5 (OUTR4)
/LEDs/led61b: LD61.4 (R), U9.41 (OUTB14)
/LEDs/led61g: LD61.3 (R), U9.39 (OUTG14)
/LEDs/led61r: LD61.2 (R), U9.40 (OUTR14)
/LEDs/led62b: LD62.4 (R), U9.38 (OUTB10)
/LEDs/led62g: LD62.3 (R), U9.36 (OUTG10)
/LEDs/led62r: LD62.2 (R), U9.37 (OUTR10)
/LEDs/led63b: LD63.4 (R), U9.35 (OUTB15)
/LEDs/led63g: LD63.3 (R), U9.33 (OUTG15)
/LEDs/led63r: LD63.2 (R), U9.34 (OUTR15)
/LEDs/led64b: LD64.4 (R), U9.32 (OUTB11)
/LEDs/led64g: LD64.3 (R), U9.30 (OUTG11)
/LEDs/led64r: LD64.2 (R), U9.31 (OUTR11)
/LEDs/led65b: LD65.4 (R), U4.47 (OUTB9)
/LEDs/led65g: LD65.3 (R), U4.45 (OUTG9)
/LEDs/led65r: LD65.2 (R), U4.46 (OUTR9)
/LEDs/led66b: LD66.4 (R), U4.44 (OUTB13)
/LEDs/led66g: LD66.3 (R), U4.42 (OUTG13)
/LEDs/led66r: LD66.2 (R), U4.43 (OUTR13)
/LEDs/led67b: LD67.4 (R), U5.41 (OUTB14)
/LEDs/led67g: LD67.3 (R), U5.39 (OUTG14)
/LEDs/led67r: LD67.2 (R), U5.40 (OUTR14)
/LEDs/led68b: LD68.4 (R), U5.38 (OUTB10)
/LEDs/led68g: LD68.3 (R), U5.36 (OUTG10)
/LEDs/led68r: LD68.2 (R), U5.37 (OUTR10)
/LEDs/led69b: LD69.4 (R), U8.22 (OUTB3)
/LEDs/led69g: LD69.3 (R), U8.24 (OUTG3)
/LEDs/led69r: LD69.2 (R), U8.23 (OUTR3)
/LEDs/led70b: LD70.4 (R), U8.25 (OUTB7)
/LEDs/led70g: LD70.3 (R), U8.27 (OUTG7)
/LEDs/led70r: LD70.2 (R), U8.26 (OUTR7)
/LEDs/led71b: LD71.4 (R), U8.19 (OUTB6)
/LEDs/led71g: LD71.3 (R), U8.21 (OUTG6)
/LEDs/led71r: LD71.2 (R), U8.20 (OUTR6)
/LEDs/led72b: LD72.4 (R), U8.16 (OUTB2)
/LEDs/led72g: LD72.3 (R), U8.18 (OUTG2)
/LEDs/led72r: LD72.2 (R), U8.17 (OUTR2)
/LEDs/led73b: LD73.4 (R), U9.53 (OUTB8)
/LEDs/led73g: LD73.3 (R), U9.51 (OUTG8)
/LEDs/led73r: LD73.2 (R), U9.52 (OUTR8)
/LEDs/led74b: LD74.4 (R), U9.50 (OUTB12)
/LEDs/led74g: LD74.3 (R), U9.48 (OUTG12)
/LEDs/led74r: LD74.2 (R), U9.49 (OUTR12)
/LEDs/led75b: LD75.4 (R), U9.47 (OUTB9)
/LEDs/led75g: LD75.3 (R), U9.45 (OUTG9)
/LEDs/led75r: LD75.2 (R), U9.46 (OUTR9)
/LEDs/led76b: LD76.4 (R), U9.44 (OUTB13)
/LEDs/led76g: LD76.3 (R), U9.42 (OUTG13)
/LEDs/led76r: LD76.2 (R), U9.43 (OUTR13)
/LEDs/led77b: LD77.4 (R), U8.32 (OUTB11)
/LEDs/led77g: LD77.3 (R), U8.30 (OUTG11)
/LEDs/led77r: LD77.2 (R), U8.31 (OUTR11)
/LEDs/led78b: LD78.4 (R), U8.35 (OUTB15)
/LEDs/led78g: LD78.3 (R), U8.33 (OUTG15)
/LEDs/led78r: LD78.2 (R), U8.34 (OUTR15)
/LEDs/led79b: LD79.4 (R), U4.41 (OUTB14)
/LEDs/led79g: LD79.3 (R), U4.39 (OUTG14)
/LEDs/led79r: LD79.2 (R), U4.40 (OUTR14)
/LEDs/led80b: LD80.4 (R), U4.35 (OUTB15)
/LEDs/led80g: LD80.3 (R), U4.33 (OUTG15)
/LEDs/led80r: LD80.2 (R), U4.34 (OUTR15)
/LEDs/led81b: LD81.4 (R), U5.47 (OUTB9)
/LEDs/led81g: LD81.3 (R), U5.45 (OUTG9)
/LEDs/led81r: LD81.2 (R), U5.46 (OUTR9)
/LEDs/led82b: LD82.4 (R), U5.44 (OUTB13)
/LEDs/led82g: LD82.3 (R), U5.42 (OUTG13)
/LEDs/led82r: LD82.2 (R), U5.43 (OUTR13)
/LEDs/led83b: LD83.4 (R), U8.7 (OUTB0)
/LEDs/led83g: LD83.3 (R), U8.9 (OUTG0)
/LEDs/led83r: LD83.2 (R), U8.8 (OUTR0)
/LEDs/led84b: LD84.4 (R), U8.10 (OUTB5)
/LEDs/led84g: LD84.3 (R), U8.12 (OUTG5)
/LEDs/led84r: LD84.2 (R), U8.11 (OUTR5)
/LEDs/led85b: LD85.4 (R), U8.13 (OUTB1)
/LEDs/led85g: LD85.3 (R), U8.15 (OUTG1)
/LEDs/led85r: LD85.2 (R), U8.14 (OUTR1)
/LEDs/led86b: LD86.4 (R), U8.4 (OUTB4)
/LEDs/led86g: LD86.3 (R), U8.6 (OUTG4)
/LEDs/led86r: LD86.2 (R), U8.5 (OUTR4)
/LEDs/led87b: LD87.4 (R), U8.44 (OUTB13)
/LEDs/led87g: LD87.3 (R), U8.42 (OUTG13)
/LEDs/led87r: LD87.2 (R), U8.43 (OUTR13)
/LEDs/led88b: LD88.4 (R), U8.47 (OUTB9)
/LEDs/led88g: LD88.3 (R), U8.45 (OUTG9)
/LEDs/led88r: LD88.2 (R), U8.46 (OUTR9)
/LEDs/led89b: LD89.4 (R), U8.50 (OUTB12)
/LEDs/led89g: LD89.3 (R), U8.48 (OUTG12)
/LEDs/led89r: LD89.2 (R), U8.49 (OUTR12)
/LEDs/led90b: LD90.4 (R), U8.53 (OUTB8)
/LEDs/led90g: LD90.3 (R), U8.51 (OUTG8)
/LEDs/led90r: LD90.2 (R), U8.52 (OUTR8)
/LEDs/led91b: LD91.4 (R), U8.41 (OUTB14)
/LEDs/led91g: LD91.3 (R), U8.39 (OUTG14)
/LEDs/led91r: LD91.2 (R), U8.40 (OUTR14)
/LEDs/led92b: LD92.4 (R), U8.38 (OUTB10)
/LEDs/led92g: LD92.3 (R), U8.36 (OUTG10)
/LEDs/led92r: LD92.2 (R), U8.37 (OUTR10)
/LEDs/led93b: LD93.4 (R), U4.38 (OUTB10)
/LEDs/led93g: LD93.3 (R), U4.36 (OUTG10)
/LEDs/led93r: LD93.2 (R), U4.37 (OUTR10)
/LEDs/led94b: LD94.4 (R), U4.32 (OUTB11)
/LEDs/led94g: LD94.3 (R), U4.30 (OUTG11)
/LEDs/led94r: LD94.2 (R), U4.31 (OUTR11)
/LEDs/led95b: LD95.4 (R), U5.53 (OUTB8)
/LEDs/led95g: LD95.3 (R), U5.51 (OUTG8)
/LEDs/led95r: LD95.2 (R), U5.52 (OUTR8)
/LEDs/led96b: LD96.4 (R), U5.50 (OUTB12)
/LEDs/led96g: LD96.3 (R), U5.48 (OUTG12)
/LEDs/led96r: LD96.2 (R), U5.49 (OUTR12)
/LEDs/led97b: LD97.4 (R), U10.50 (OUTB12)
/LEDs/led97g: LD97.3 (R), U10.48 (OUTG12)
/LEDs/led97r: LD97.2 (R), U10.49 (OUTR12)
/LEDs/led98b: LD98.4 (R), U10.47 (OUTB9)
/LEDs/led98g: LD98.3 (R), U10.45 (OUTG9)
/LEDs/led98r: LD98.2 (R), U10.46 (OUTR9)
/LEDs/led99b: LD99.4 (R), U10.44 (OUTB13)
/LEDs/led99g: LD99.3 (R), U10.42 (OUTG13)
/LEDs/led99r: LD99.2 (R), U10.43 (OUTR13)
/LEDs/led100b: LD100.4 (R), U10.53 (OUTB8)
/LEDs/led100g: LD100.3 (R), U10.51 (OUTG8)
/LEDs/led100r: LD100.2 (R), U10.52 (OUTR8)
/LEDs/led101b: LD101.4 (R), U10.13 (OUTB1)
/LEDs/led101g: LD101.3 (R), U10.15 (OUTG1)
/LEDs/led101r: LD101.2 (R), U10.14 (OUTR1)
/LEDs/led102b: LD102.4 (R), U10.10 (OUTB5)
/LEDs/led102g: LD102.3 (R), U10.12 (OUTG5)
/LEDs/led102r: LD102.2 (R), U10.11 (OUTR5)
/LEDs/led103b: LD103.4 (R), U10.7 (OUTB0)
/LEDs/led103g: LD103.3 (R), U10.9 (OUTG0)
/LEDs/led103r: LD103.2 (R), U10.8 (OUTR0)
/LEDs/led104b: LD104.4 (R), U10.4 (OUTB4)
/LEDs/led104g: LD104.3 (R), U10.6 (OUTG4)
/LEDs/led104r: LD104.2 (R), U10.5 (OUTR4)
/LEDs/led105b: LD105.4 (R), U10.16 (OUTB2)
/LEDs/led105g: LD105.3 (R), U10.18 (OUTG2)
/LEDs/led105r: LD105.2 (R), U10.17 (OUTR2)
/LEDs/led106b: LD106.4 (R), U10.19 (OUTB6)
/LEDs/led106g: LD106.3 (R), U10.21 (OUTG6)
/LEDs/led106r: LD106.2 (R), U10.20 (OUTR6)
/LEDs/led107b: LD107.4 (R), U14.19 (OUTB6)
/LEDs/led107g: LD107.3 (R), U14.21 (OUTG6)
/LEDs/led107r: LD107.2 (R), U14.20 (OUTR6)
/LEDs/led108b: LD108.4 (R), U14.25 (OUTB7)
/LEDs/led108g: LD108.3 (R), U14.27 (OUTG7)
/LEDs/led108r: LD108.2 (R), U14.26 (OUTR7)
/LEDs/led109b: LD109.4 (R), U15.4 (OUTB4)
/LEDs/led109g: LD109.3 (R), U15.6 (OUTG4)
/LEDs/led109r: LD109.2 (R), U15.5 (OUTR4)
/LEDs/led110b: LD110.4 (R), U15.7 (OUTB0)
/LEDs/led110g: LD110.3 (R), U15.9 (OUTG0)
/LEDs/led110r: LD110.2 (R), U15.8 (OUTR0)
/LEDs/led111b: LD111.4 (R), U10.35 (OUTB15)
/LEDs/led111g: LD111.3 (R), U10.33 (OUTG15)
/LEDs/led111r: LD111.2 (R), U10.34 (OUTR15)
/LEDs/led112b: LD112.4 (R), U10.32 (OUTB11)
/LEDs/led112g: LD112.3 (R), U10.30 (OUTG11)
/LEDs/led112r: LD112.2 (R), U10.31 (OUTR11)
/LEDs/led113b: LD113.4 (R), U10.38 (OUTB10)
/LEDs/led113g: LD113.3 (R), U10.36 (OUTG10)
/LEDs/led113r: LD113.2 (R), U10.37 (OUTR10)
/LEDs/led114b: LD114.4 (R), U10.41 (OUTB14)
/LEDs/led114g: LD114.3 (R), U10.39 (OUTG14)
/LEDs/led114r: LD114.2 (R), U10.40 (OUTR14)
/LEDs/led115b: LD115.4 (R), U11.4 (OUTB4)
/LEDs/led115g: LD115.3 (R), U11.6 (OUTG4)
/LEDs/led115r: LD115.2 (R), U11.5 (OUTR4)
/LEDs/led116b: LD116.4 (R), U11.7 (OUTB0)
/LEDs/led116g: LD116.3 (R), U11.9 (OUTG0)
/LEDs/led116r: LD116.2 (R), U11.8 (OUTR0)
/LEDs/led117b: LD117.4 (R), U11.10 (OUTB5)
/LEDs/led117g: LD117.3 (R), U11.12 (OUTG5)
/LEDs/led117r: LD117.2 (R), U11.11 (OUTR5)
/LEDs/led118b: LD118.4 (R), U11.13 (OUTB1)
/LEDs/led118g: LD118.3 (R), U11.15 (OUTG1)
/LEDs/led118r: LD118.2 (R), U11.14 (OUTR1)
/LEDs/led119b: LD119.4 (R), U10.25 (OUTB7)
/LEDs/led119g: LD119.3 (R), U10.27 (OUTG7)
/LEDs/led119r: LD119.2 (R), U10.26 (OUTR7)
/LEDs/led120b: LD120.4 (R), U10.22 (OUTB3)
/LEDs/led120g: LD120.3 (R), U10.24 (OUTG3)
/LEDs/led120r: LD120.2 (R), U10.23 (OUTR3)
/LEDs/led121b: LD121.4 (R), U14.16 (OUTB2)
/LEDs/led121g: LD121.3 (R), U14.18 (OUTG2)
/LEDs/led121r: LD121.2 (R), U14.17 (OUTR2)
/LEDs/led122b: LD122.4 (R), U14.22 (OUTB3)
/LEDs/led122g: LD122.3 (R), U14.24 (OUTG3)
/LEDs/led122r: LD122.2 (R), U14.23 (OUTR3)
/LEDs/led123b: LD123.4 (R), U15.10 (OUTB5)
/LEDs/led123g: LD123.3 (R), U15.12 (OUTG5)
/LEDs/led123r: LD123.2 (R), U15.11 (OUTR5)
/LEDs/led124b: LD124.4 (R), U15.13 (OUTB1)
/LEDs/led124g: LD124.3 (R), U15.15 (OUTG1)
/LEDs/led124r: LD124.2 (R), U15.14 (OUTR1)
/LEDs/led125b: LD125.4 (R), U11.47 (OUTB9)
/LEDs/led125g: LD125.3 (R), U11.45 (OUTG9)
/LEDs/led125r: LD125.2 (R), U11.46 (OUTR9)
/LEDs/led126b: LD126.4 (R), U11.44 (OUTB13)
/LEDs/led126g: LD126.3 (R), U11.42 (OUTG13)
/LEDs/led126r: LD126.2 (R), U11.43 (OUTR13)
/LEDs/led127b: LD127.4 (R), U11.41 (OUTB14)
/LEDs/led127g: LD127.3 (R), U11.39 (OUTG14)
/LEDs/led127r: LD127.2 (R), U11.40 (OUTR14)
/LEDs/led128b: LD128.4 (R), U11.50 (OUTB12)
/LEDs/led128g: LD128.3 (R), U11.48 (OUTG12)
/LEDs/led128r: LD128.2 (R), U11.49 (OUTR12)
/LEDs/led129b: LD129.4 (R), U11.53 (OUTB8)
/LEDs/led129g: LD129.3 (R), U11.51 (OUTG8)
/LEDs/led129r: LD129.2 (R), U11.52 (OUTR8)
/LEDs/led130b: LD130.4 (R), U11.16 (OUTB2)
/LEDs/led130g: LD130.3 (R), U11.18 (OUTG2)
/LEDs/led130r: LD130.2 (R), U11.17 (OUTR2)
/LEDs/led131b: LD131.4 (R), U11.19 (OUTB6)
/LEDs/led131g: LD131.3 (R), U11.21 (OUTG6)
/LEDs/led131r: LD131.2 (R), U11.20 (OUTR6)
/LEDs/led132b: LD132.4 (R), U11.22 (OUTB3)
/LEDs/led132g: LD132.3 (R), U11.24 (OUTG3)
/LEDs/led132r: LD132.2 (R), U11.23 (OUTR3)
/LEDs/led133b: LD133.4 (R), U11.25 (OUTB7)
/LEDs/led133g: LD133.3 (R), U11.27 (OUTG7)
/LEDs/led133r: LD133.2 (R), U11.26 (OUTR7)
/LEDs/led134b: LD134.4 (R), U14.10 (OUTB5)
/LEDs/led134g: LD134.3 (R), U14.12 (OUTG5)
/LEDs/led134r: LD134.2 (R), U14.11 (OUTR5)
/LEDs/led135b: LD135.4 (R), U14.13 (OUTB1)
/LEDs/led135g: LD135.3 (R), U14.15 (OUTG1)
/LEDs/led135r: LD135.2 (R), U14.14 (OUTR1)
/LEDs/led136b: LD136.4 (R), U15.16 (OUTB2)
/LEDs/led136g: LD136.3 (R), U15.18 (OUTG2)
/LEDs/led136r: LD136.2 (R), U15.17 (OUTR2)
/LEDs/led137b: LD137.4 (R), U15.19 (OUTB6)
/LEDs/led137g: LD137.3 (R), U15.21 (OUTG6)
/LEDs/led137r: LD137.2 (R), U15.20 (OUTR6)
/LEDs/led138b: LD138.4 (R), U11.38 (OUTB10)
/LEDs/led138g: LD138.3 (R), U11.36 (OUTG10)
/LEDs/led138r: LD138.2 (R), U11.37 (OUTR10)
/LEDs/led139b: LD139.4 (R), U11.35 (OUTB15)
/LEDs/led139g: LD139.3 (R), U11.33 (OUTG15)
/LEDs/led139r: LD139.2 (R), U11.34 (OUTR15)
/LEDs/led140b: LD140.4 (R), U11.32 (OUTB11)
/LEDs/led140g: LD140.3 (R), U11.30 (OUTG11)
/LEDs/led140r: LD140.2 (R), U11.31 (OUTR11)
/LEDs/led141b: LD141.4 (R), U12.53 (OUTB8)
/LEDs/led141g: LD141.3 (R), U12.51 (OUTG8)
/LEDs/led141r: LD141.2 (R), U12.52 (OUTR8)
/LEDs/led142b: LD142.4 (R), U12.16 (OUTB2)
/LEDs/led142g: LD142.3 (R), U12.18 (OUTG2)
/LEDs/led142r: LD142.2 (R), U12.17 (OUTR2)
/LEDs/led143b: LD143.4 (R), U12.13 (OUTB1)
/LEDs/led143g: LD143.3 (R), U12.15 (OUTG1)
/LEDs/led143r: LD143.2 (R), U12.14 (OUTR1)
/LEDs/led144b: LD144.4 (R), U12.10 (OUTB5)
/LEDs/led144g: LD144.3 (R), U12.12 (OUTG5)
/LEDs/led144r: LD144.2 (R), U12.11 (OUTR5)
/LEDs/led145b: LD145.4 (R), U12.7 (OUTB0)
/LEDs/led145g: LD145.3 (R), U12.9 (OUTG0)
/LEDs/led145r: LD145.2 (R), U12.8 (OUTR0)
/LEDs/led146b: LD146.4 (R), U12.4 (OUTB4)
/LEDs/led146g: LD146.3 (R), U12.6 (OUTG4)
/LEDs/led146r: LD146.2 (R), U12.5 (OUTR4)
/LEDs/led147b: LD147.4 (R), U14.4 (OUTB4)
/LEDs/led147g: LD147.3 (R), U14.6 (OUTG4)
/LEDs/led147r: LD147.2 (R), U14.5 (OUTR4)
/LEDs/led148b: LD148.4 (R), U14.7 (OUTB0)
/LEDs/led148g: LD148.3 (R), U14.9 (OUTG0)
/LEDs/led148r: LD148.2 (R), U14.8 (OUTR0)
/LEDs/led149b: LD149.4 (R), U15.22 (OUTB3)
/LEDs/led149g: LD149.3 (R), U15.24 (OUTG3)
/LEDs/led149r: LD149.2 (R), U15.23 (OUTR3)
/LEDs/led150b: LD150.4 (R), U15.25 (OUTB7)
/LEDs/led150g: LD150.3 (R), U15.27 (OUTG7)
/LEDs/led150r: LD150.2 (R), U15.26 (OUTR7)
/LEDs/led151b: LD151.4 (R), U12.50 (OUTB12)
/LEDs/led151g: LD151.3 (R), U12.48 (OUTG12)
/LEDs/led151r: LD151.2 (R), U12.49 (OUTR12)
/LEDs/led152b: LD152.4 (R), U12.47 (OUTB9)
/LEDs/led152g: LD152.3 (R), U12.45 (OUTG9)
/LEDs/led152r: LD152.2 (R), U12.46 (OUTR9)
/LEDs/led153b: LD153.4 (R), U12.44 (OUTB13)
/LEDs/led153g: LD153.3 (R), U12.42 (OUTG13)
/LEDs/led153r: LD153.2 (R), U12.43 (OUTR13)
/LEDs/led154b: LD154.4 (R), U12.41 (OUTB14)
/LEDs/led154g: LD154.3 (R), U12.39 (OUTG14)
/LEDs/led154r: LD154.2 (R), U12.40 (OUTR14)
/LEDs/led155b: LD155.4 (R), U13.47 (OUTB9)
/LEDs/led155g: LD155.3 (R), U13.45 (OUTG9)
/LEDs/led155r: LD155.2 (R), U13.46 (OUTR9)
/LEDs/led156b: LD156.4 (R), U13.4 (OUTB4)
/LEDs/led156g: LD156.3 (R), U13.6 (OUTG4)
/LEDs/led156r: LD156.2 (R), U13.5 (OUTR4)
/LEDs/led157b: LD157.4 (R), U13.7 (OUTB0)
/LEDs/led157g: LD157.3 (R), U13.9 (OUTG0)
/LEDs/led157r: LD157.2 (R), U13.8 (OUTR0)
/LEDs/led158b: LD158.4 (R), U13.10 (OUTB5)
/LEDs/led158g: LD158.3 (R), U13.12 (OUTG5)
/LEDs/led158r: LD158.2 (R), U13.11 (OUTR5)
/LEDs/led159b: LD159.4 (R), U13.13 (OUTB1)
/LEDs/led159g: LD159.3 (R), U13.15 (OUTG1)
/LEDs/led159r: LD159.2 (R), U13.14 (OUTR1)
/LEDs/led160b: LD160.4 (R), U12.25 (OUTB7)
/LEDs/led160g: LD160.3 (R), U12.27 (OUTG7)
/LEDs/led160r: LD160.2 (R), U12.26 (OUTR7)
/LEDs/led161b: LD161.4 (R), U12.22 (OUTB3)
/LEDs/led161g: LD161.3 (R), U12.24 (OUTG3)
/LEDs/led161r: LD161.2 (R), U12.23 (OUTR3)
/LEDs/led162b: LD162.4 (R), U12.19 (OUTB6)
/LEDs/led162g: LD162.3 (R), U12.21 (OUTG6)
/LEDs/led162r: LD162.2 (R), U12.20 (OUTR6)
/LEDs/led163b: LD163.4 (R), U12.38 (OUTB10)
/LEDs/led163g: LD163.3 (R), U12.36 (OUTG10)
/LEDs/led163r: LD163.2 (R), U12.37 (OUTR10)
/LEDs/led164b: LD164.4 (R), U12.35 (OUTB15)
/LEDs/led164g: LD164.3 (R), U12.33 (OUTG15)
/LEDs/led164r: LD164.2 (R), U12.34 (OUTR15)
/LEDs/led165b: LD165.4 (R), U12.32 (OUTB11)
/LEDs/led165g: LD165.3 (R), U12.30 (OUTG11)
/LEDs/led165r: LD165.2 (R), U12.31 (OUTR11)
/LEDs/led166b: LD166.4 (R), U13.44 (OUTB13)
/LEDs/led166g: LD166.3 (R), U13.42 (OUTG13)
/LEDs/led166r: LD166.2 (R), U13.43 (OUTR13)
/LEDs/led167b: LD167.4 (R), U13.16 (OUTB2)
/LEDs/led167g: LD167.3 (R), U13.18 (OUTG2)
/LEDs/led167r: LD167.2 (R), U13.17 (OUTR2)
/LEDs/led168b: LD168.4 (R), U13.22 (OUTB3)
/LEDs/led168g: LD168.3 (R), U13.24 (OUTG3)
/LEDs/led168r: LD168.2 (R), U13.23 (OUTR3)
/LEDs/led169b: LD169.4 (R), U13.19 (OUTB6)
/LEDs/led169g: LD169.3 (R), U13.21 (OUTG6)
/LEDs/led169r: LD169.2 (R), U13.20 (OUTR6)
/LEDs/led170b: LD170.4 (R), U14.53 (OUTB8)
/LEDs/led170g: LD170.3 (R), U14.51 (OUTG8)
/LEDs/led170r: LD170.2 (R), U14.52 (OUTR8)
/LEDs/led171b: LD171.4 (R), U14.44 (OUTB13)
/LEDs/led171g: LD171.3 (R), U14.42 (OUTG13)
/LEDs/led171r: LD171.2 (R), U14.43 (OUTR13)
/LEDs/led172b: LD172.4 (R), U15.47 (OUTB9)
/LEDs/led172g: LD172.3 (R), U15.45 (OUTG9)
/LEDs/led172r: LD172.2 (R), U15.46 (OUTR9)
/LEDs/led173b: LD173.4 (R), U15.38 (OUTB10)
/LEDs/led173g: LD173.3 (R), U15.36 (OUTG10)
/LEDs/led173r: LD173.2 (R), U15.37 (OUTR10)
/LEDs/led174b: LD174.4 (R), U13.53 (OUTB8)
/LEDs/led174g: LD174.3 (R), U13.51 (OUTG8)
/LEDs/led174r: LD174.2 (R), U13.52 (OUTR8)
/LEDs/led175b: LD175.4 (R), U13.41 (OUTB14)
/LEDs/led175g: LD175.3 (R), U13.39 (OUTG14)
/LEDs/led175r: LD175.2 (R), U13.40 (OUTR14)
/LEDs/led176b: LD176.4 (R), U13.38 (OUTB10)
/LEDs/led176g: LD176.3 (R), U13.36 (OUTG10)
/LEDs/led176r: LD176.2 (R), U13.37 (OUTR10)
/LEDs/led177b: LD177.4 (R), U13.25 (OUTB7)
/LEDs/led177g: LD177.3 (R), U13.27 (OUTG7)
/LEDs/led177r: LD177.2 (R), U13.26 (OUTR7)
/LEDs/led178b: LD178.4 (R), U14.50 (OUTB12)
/LEDs/led178g: LD178.3 (R), U14.48 (OUTG12)
/LEDs/led178r: LD178.2 (R), U14.49 (OUTR12)
/LEDs/led179b: LD179.4 (R), U14.41 (OUTB14)
/LEDs/led179g: LD179.3 (R), U14.39 (OUTG14)
/LEDs/led179r: LD179.2 (R), U14.40 (OUTR14)
/LEDs/led180b: LD180.4 (R), U14.35 (OUTB15)
/LEDs/led180g: LD180.3 (R), U14.33 (OUTG15)
/LEDs/led180r: LD180.2 (R), U14.34 (OUTR15)
/LEDs/led181b: LD181.4 (R), U15.53 (OUTB8)
/LEDs/led181g: LD181.3 (R), U15.51 (OUTG8)
/LEDs/led181r: LD181.2 (R), U15.52 (OUTR8)
/LEDs/led182b: LD182.4 (R), U15.44 (OUTB13)
/LEDs/led182g: LD182.3 (R), U15.42 (OUTG13)
/LEDs/led182r: LD182.2 (R), U15.43 (OUTR13)
/LEDs/led183b: LD183.4 (R), U15.35 (OUTB15)
/LEDs/led183g: LD183.3 (R), U15.33 (OUTG15)
/LEDs/led183r: LD183.2 (R), U15.34 (OUTR15)
/LEDs/led184b: LD184.4 (R), U13.50 (OUTB12)
/LEDs/led184g: LD184.3 (R), U13.48 (OUTG12)
/LEDs/led184r: LD184.2 (R), U13.49 (OUTR12)
/LEDs/led185b: LD185.4 (R), U13.32 (OUTB11)
/LEDs/led185g: LD185.3 (R), U13.30 (OUTG11)
/LEDs/led185r: LD185.2 (R), U13.31 (OUTR11)
/LEDs/led186b: LD186.4 (R), U13.35 (OUTB15)
/LEDs/led186g: LD186.3 (R), U13.33 (OUTG15)
/LEDs/led186r: LD186.2 (R), U13.34 (OUTR15)
/LEDs/led187b: LD187.4 (R), U14.47 (OUTB9)
/LEDs/led187g: LD187.3 (R), U14.45 (OUTG9)
/LEDs/led187r: LD187.2 (R), U14.46 (OUTR9)
/LEDs/led188b: LD188.4 (R), U14.38 (OUTB10)
/LEDs/led188g: LD188.3 (R), U14.36 (OUTG10)
/LEDs/led188r: LD188.2 (R), U14.37 (OUTR10)
/LEDs/led189b: LD189.4 (R), U14.32 (OUTB11)
/LEDs/led189g: LD189.3 (R), U14.30 (OUTG11)
/LEDs/led189r: LD189.2 (R), U14.31 (OUTR11)
/LEDs/led190b: LD190.4 (R), U15.50 (OUTB12)
/LEDs/led190g: LD190.3 (R), U15.48 (OUTG12)
/LEDs/led190r: LD190.2 (R), U15.49 (OUTR12)
/LEDs/led191b: LD191.4 (R), U15.41 (OUTB14)
/LEDs/led191g: LD191.3 (R), U15.39 (OUTG14)
/LEDs/led191r: LD191.2 (R), U15.40 (OUTR14)
/LEDs/led192b: LD192.4 (R), U15.32 (OUTB11)
/LEDs/led192g: LD192.3 (R), U15.30 (OUTG11)
/LEDs/led192r: LD192.2 (R), U15.31 (OUTR11)
/LEDs/sout4_5: U4.28 (SOUT), U5.1 (SIN)
/LEDs/sout6_7: U6.28 (SOUT), U7.1 (SIN)
/LEDs/sout8_9: U8.28 (SOUT), U9.1 (SIN)
/LEDs/sout10_11: U10.28 (SOUT), U11.1 (SIN)
/LEDs/sout12_13: U12.28 (SOUT), U13.1 (SIN)
/LEDs/sout14_15: U14.28 (SOUT), U15.1 (SIN)
/gsclk1: U4.55 (GSCLK), U5.55 (GSCLK); also elsewhere on the board
/gsclk2: U6.55 (GSCLK), U7.55 (GSCLK); also elsewhere on the board
/gsclk3: U8.55 (GSCLK), U9.55 (GSCLK); also elsewhere on the board
/gsclk4: U10.55 (GSCLK), U11.55 (GSCLK); also elsewhere on the board
/gsclk5: U12.55 (GSCLK), U13.55 (GSCLK); also elsewhere on the board
/gsclk6: U14.55 (GSCLK), U15.55 (GSCLK); also elsewhere on the board
/lat1: U4.3 (LAT), U5.3 (LAT); also elsewhere on the board
/lat2: U6.3 (LAT), U7.3 (LAT); also elsewhere on the board
/lat3: U8.3 (LAT), U9.3 (LAT); also elsewhere on the board
/lat4: U10.3 (LAT), U11.3 (LAT); also elsewhere on the board
/lat5: U12.3 (LAT), U13.3 (LAT); also elsewhere on the board
/lat6: U14.3 (LAT), U15.3 (LAT); also elsewhere on the board
/sclk1: U4.2 (SCLK), U5.2 (SCLK); also elsewhere on the board
/sclk2: U6.2 (SCLK), U7.2 (SCLK); also elsewhere on the board
/sclk3: U8.2 (SCLK), U9.2 (SCLK); also elsewhere on the board
/sclk4: U10.2 (SCLK), U11.2 (SCLK); also elsewhere on the board
/sclk5: U12.2 (SCLK), U13.2 (SCLK); also elsewhere on the board
/sclk6: U14.2 (SCLK), U15.2 (SCLK); also elsewhere on the board
/sin1: U4.1 (SIN); also elsewhere on the board
/sin2: U6.1 (SIN); also elsewhere on the board
/sin3: U8.1 (SIN); also elsewhere on the board
/sin4: U10.1 (SIN); also elsewhere on the board
/sin5: U12.1 (SIN); also elsewhere on the board
/sin6: U14.1 (SIN); also elsewhere on the board
/sout1: U5.28 (SOUT); also elsewhere on the board
/sout2: U7.28 (SOUT); also elsewhere on the board
/sout3: U9.28 (SOUT); also elsewhere on the board
/sout4: U11.28 (SOUT); also elsewhere on the board
/sout5: U13.28 (SOUT); also elsewhere on the board
/sout6: U15.28 (SOUT); also elsewhere on the board
GND: C32.2, C33.2, C34.2, C35.2, C36.2, C37.2, C38.2, C39.2, C40.2, C41.2, C42.2, C43.2, C44.2, C45.2, U4.29 (GND), U4.56 (GND), U4.57 (GND_(PowerPAD)), U5.29 (GND), U5.56 (GND), U5.57 (GND_(PowerPAD)), U6.29 (GND), U6.56 (GND), U6.57 (GND_(PowerPAD)), U7.29 (GND), U7.56 (GND), U7.57 (GND_(PowerPAD)), U8.29 (GND), U8.56 (GND), U8.57 (GND_(PowerPAD)), U9.29 (GND), U9.56 (GND), U9.57 (GND_(PowerPAD)), U10.29 (GND), U10.56 (GND), U10.57 (GND_(PowerPAD)), U11.29 (GND), U11.56 (GND), U11.57 (GND_(PowerPAD)), U12.29 (GND), U12.56 (GND), U12.57 (GND_(PowerPAD)), U13.29 (GND), U13.56 (GND), U13.57 (GND_(PowerPAD)), U14.29 (GND), U14.56 (GND), U14.57 (GND_(PowerPAD)), U15.29 (GND), U15.56 (GND), U15.57 (GND_(PowerPAD)); also elsewhere on the board

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
