knielsen/pcb_ledtorus_2/pcb_ledtorus_2.kicad_pcb

## KiCad design pcb_ledtorus_2.kicad_pcb (continued)

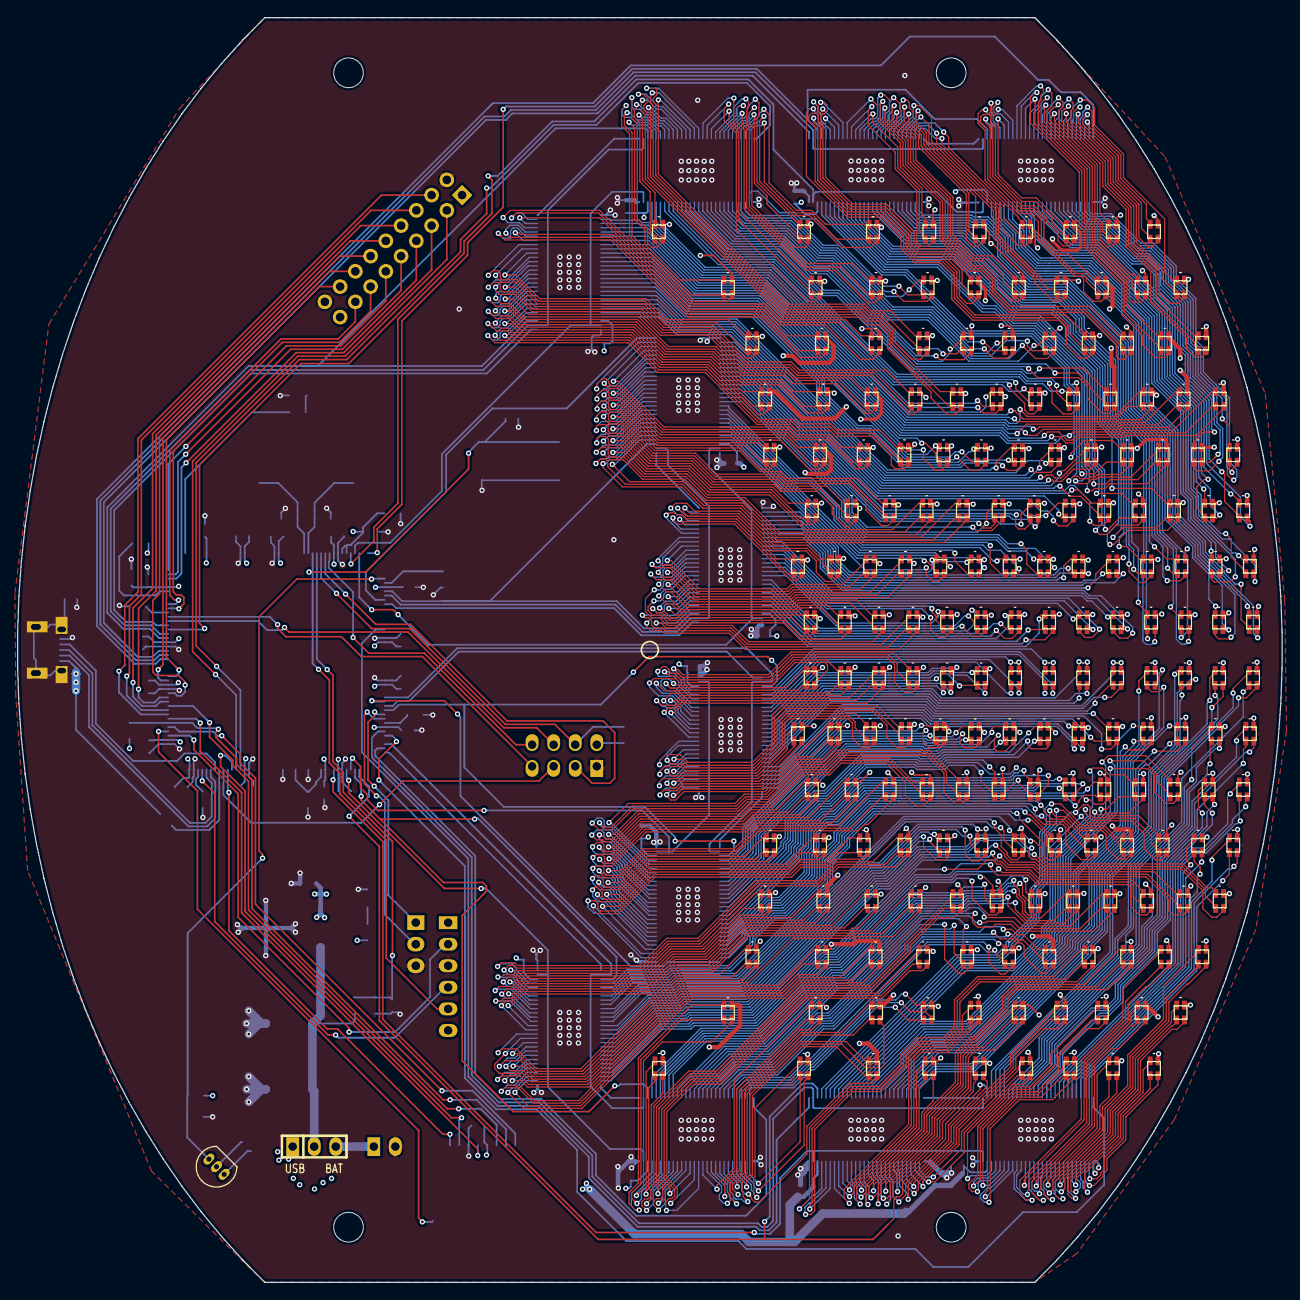
[picture p7: board pcb_ledtorus_2.kicad_pcb from above]

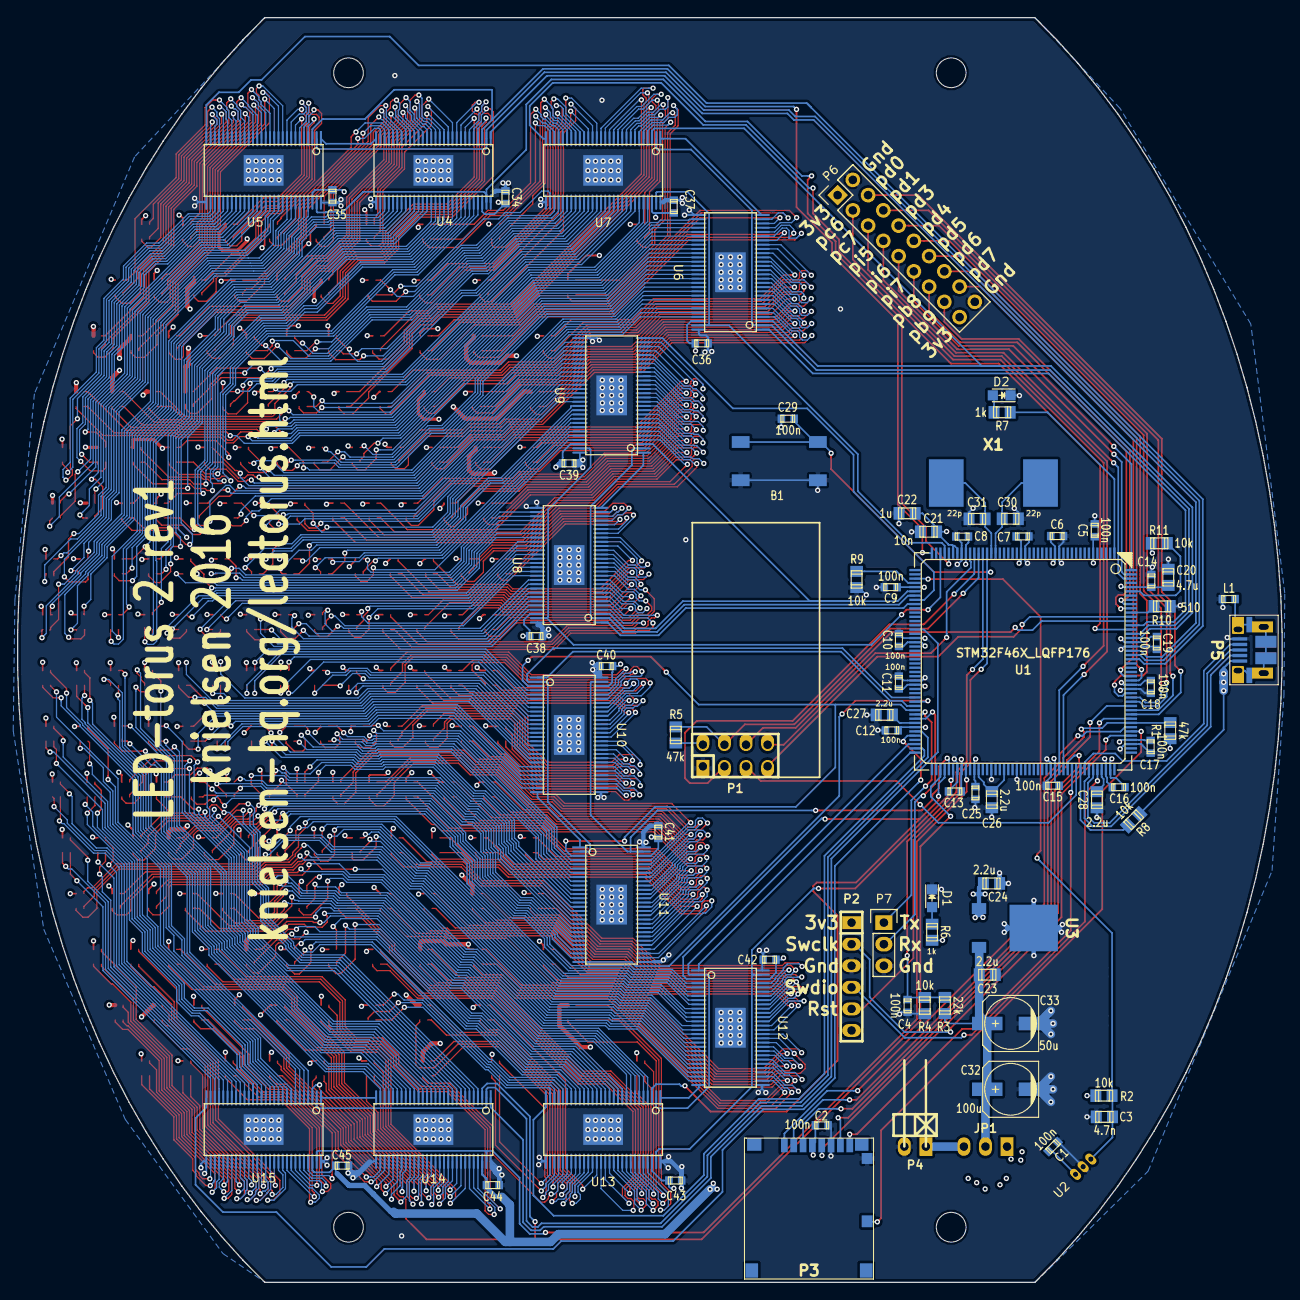
[picture p8: board pcb_ledtorus_2.kicad_pcb from below]

Board: 4 copper layers, 149.0 x 149.0 mm, 276 parts (82 on the bottom side), 667 nets.
