knielsen/pcb_ledtorus_2/(commit log)

2015-11-01 Initial draft of PCB for LED-torus 2
    Some basic stuff done, not complete/checked yet.
    LEDs and TLCs still missing.
    [pcb_ledtorus_2.kicad_pcb, pcb_ledtorus_2.sch, power.sch]
2015-11-01 First draft of LEDs schematics sheet.
    Needs some processing to get numbering right, easier to do with some
    scripting.
    [leds.sch, pcb_ledtorus_2.sch, power.sch]
2015-11-02 Fix sin/sclk/sout/lat/gsclk 1-6 pins and labels.
    [leds.sch, pcb_ledtorus_2.sch]
2015-11-02 Fix alignment of everything to 50 mil
    [pcb_ledtorus_2.sch, power.sch]
2015-11-02 Assign labels led{1..192}{r,g,b} to all LED pins.
    (This is just an intermediate assignment to TLC outputs; real
    assignments will be determined later, according to what works best for
    the PCB routing).
    [leds.sch]
2015-11-02 Misc. small fixes, DRC (almost) passes now.
    [leds.sch, pcb_ledtorus_2.sch, power.sch]
2015-11-03 Couple small fixes and tweaks.
    Some resistors added on inputs connected directly to power lines.
    Few labels added.
    [pcb_ledtorus_2.sch, power.sch]
2015-11-03 Basic netlist with footprint assignment and import into pcbnew
    [leds.sch, pcb_ledtorus_2.kicad_pcb, pcb_ledtorus_2.sch, power.sch]
2015-11-03 Place LEDs for PCB routing.
    [pcb_ledtorus_2.kicad_pcb]
2015-11-03 Add elliptical board outline
    [pcb_ledtorus_2.kicad_pcb]
2015-11-03 Add power planes
    [pcb_ledtorus_2.kicad_pcb]
2015-11-03 Move a couple footprints out a bit.
    [pcb_ledtorus_2.kicad_pcb]
2015-11-03 Component PCB sides, and 3d models.
    [pcb_ledtorus_2.kicad_pcb]
2015-11-04 Couple small tweaks, 3d shapes.
    [pcb_ledtorus_2.kicad_pcb, power.sch]
2015-12-31 Some experiments with a way to route the LEDs
    [leds.sch, pcb_ledtorus_2.kicad_pcb]
2016-02-16 Intermediate commit
    [pcb_ledtorus_2.kicad_pcb]
2016-03-08 Some partial ideas for LEDs and TLCs placement and routing.
    [leds.sch, pcb_ledtorus_2.dsn, pcb_ledtorus_2.kicad_pcb]
2016-03-15 Good progress on LED routing.
    Upper half now routed with 6/6 mil tracks/clearance.
    Still need to fit 5V vias for all LEDs, hopefully vias can find room.
    Looks promising - if everything works, lower half should be doable the
    same way.
    [leds.sch, pcb_ledtorus_2.kicad_pcb]
2016-03-15 Some routing of LEDs VCC.
    It's tight, but it looks possible.
    [pcb_ledtorus_2.kicad_pcb]
2016-03-16 First reasonably complete routing of upper half of LEDs.
    All LEDs have vias to power plane now. And TLCs have power and de-coupling.
    Everything seems to fit, just.
    [leds.sch, pcb_ledtorus_2.kicad_pcb]
2016-03-17 Small component changes.
    Fix couple of missing footprints. Make 100nF caps 0603.
    Some very rough component placement to avoid overlap.
    [pcb_ledtorus_2.kicad_pcb, pcb_ledtorus_2.sch, power.sch]
2016-03-17 Fix so that DRC passes (with lots of unconnected)
    [pcb_ledtorus_2.kicad_pcb]
2016-03-17 First rough component placement, looks ok.
    [pcb_ledtorus_2.kicad_pcb]
2016-03-18 Some preliminary routing of signals between TLCs and MCU.
    Mostly to check that everything looks reasonably possible.
    [pcb_ledtorus_2.kicad_pcb, pcb_ledtorus_2.sch]
2016-03-18 Rip out all LED routing in lower half in preparation for proper routing like top half.
    [pcb_ledtorus_2.kicad_pcb]
2016-03-18 Fix LED-mapping for lower half to match upper half.
    (In schematics and netlist).
    [leds.sch, pcb_ledtorus_2.kicad_pcb]
2016-03-18 Back TLC part of lower half of LEDs routed.
    [leds.sch, pcb_ledtorus_2.kicad_pcb, pcb_ledtorus_2.sch]
2016-03-19 Complete routing of LEDs.
    Probably a good idea to do some additional cleanup, but it seems
    already reasonable.
    [leds.sch, pcb_ledtorus_2.kicad_pcb]
2016-03-19 Some cleanup of the LED routing.
    [leds.sch, pcb_ledtorus_2.kicad_pcb]
2016-03-19 More LED cleanup routing.
    [pcb_ledtorus_2.kicad_pcb]
2016-03-19 More LED routing cleanup
    [pcb_ledtorus_2.kicad_pcb]
2016-03-21 Preliminary routing of most remaning signals.
    [pcb_ledtorus_2.kicad_pcb]
2016-03-23 First version that fully passes DRC.
    Still some polishing to do (like extra GPIO header, general cleanup, ...).
    [leds.sch, pcb_ledtorus_2.kicad_pcb, pcb_ledtorus_2.sch, power.sch]
2016-03-24 Fix LED polarity (+ small cleanups).
    [pcb_ledtorus_2.kicad_pcb, power.sch]
2016-03-24 Cleanup back routing on U6 (looks much improved, really).
    [pcb_ledtorus_2.kicad_pcb]
2016-03-24 Cleanup back routing on U5
    [pcb_ledtorus_2.kicad_pcb]
2016-03-24 Cleanup back routing on U4
    [pcb_ledtorus_2.kicad_pcb]
2016-03-24 More cleanups above LEDs
    [pcb_ledtorus_2.kicad_pcb]
2016-03-24 Cleanup back routing on U7
    [leds.sch, pcb_ledtorus_2.kicad_pcb, pcb_ledtorus_2.sch]
2016-03-24 Cleanup back routing on U9
    [leds.sch, pcb_ledtorus_2.kicad_pcb]
2016-03-24 Cleanup back routing on U8
    [pcb_ledtorus_2.kicad_pcb]
2016-03-24 Cleanup back routing on U10
    [pcb_ledtorus_2.kicad_pcb]
2016-03-24 Cleanup back routing on U11
    [pcb_ledtorus_2.kicad_pcb]
2016-03-24 Cleanup back routing on U12
    [pcb_ledtorus_2.kicad_pcb]
2016-03-24 Cleanup back routing on U13
    [pcb_ledtorus_2.kicad_pcb]
2016-03-25 Cleanup back routing on U14
    [pcb_ledtorus_2.kicad_pcb]
2016-03-25 Cleanup back routing on U15
    [pcb_ledtorus_2.kicad_pcb]
2016-03-26 Some misc. small LED routing cleanups.
    [leds.sch, pcb_ledtorus_2.kicad_pcb]
2016-03-27 Create new GPIO header.
    Has 14 GPIOs with reasonable availability of peripherals (timers, usarts, ...).
    The location is in upper left; USB is moved to the middle left.
    (Neither USB nor generic GPIO are expected to be populated on the
    actual LED-torus, but could turn out useful for other purposes).
    Routing for this is preliminary, needs cleanup.
    [leds.sch, pcb_ledtorus_2.kicad_pcb, pcb_ledtorus_2.sch, power.sch]
2016-03-27 Move decoupling caps as close to the MCU as possible.
    [pcb_ledtorus_2.kicad_pcb]
2016-03-27 Cleanup GPIO routing
    [pcb_ledtorus_2.kicad_pcb]
2016-03-27 Rotate nRF 180 degrees, and cleanup the routing a bit.
    [pcb_ledtorus_2.kicad_pcb]
2016-03-27 Switch user LED to PE2.
    (PC13, as it was before, has limited current sink capabilities).
    [pcb_ledtorus_2.kicad_pcb, pcb_ledtorus_2.sch]
2016-03-27 Misc. routing cleanup.
    [pcb_ledtorus_2.kicad_pcb]
2016-03-27 More routing cleanup. Starting to look good now.
    [pcb_ledtorus_2.kicad_pcb]
2016-03-27 Small tweaks in routing.
    [pcb_ledtorus_2.kicad_pcb]
2016-03-28 Remove incorrect routing of PB2 as SWO.
    Also some misc. routing cleanups.
    [pcb_ledtorus_2.kicad_pcb, pcb_ledtorus_2.sch]
2016-03-28 Remove stray non-default grid origin
    [pcb_ledtorus_2.kicad_pcb]
2016-03-28 Fix silk screen.
    [pcb_ledtorus_2.kicad_pcb]
2016-03-29 Initial gerber generation
    [pcb_ledtorus_2-B.Cu.gbl, pcb_ledtorus_2-B.Mask.gbs, pcb_ledtorus_2-B.SilkS.gbo, pcb_ledtorus_2-Edge.Cuts.gm1, pcb_ledtorus_2-F.Cu.gtl, pcb_ledtorus_2-F.Mask.gts, pcb_ledtorus_2-F.SilkS.gto, pcb_ledtorus_2.drl]
2016-03-29 Move usb to back side of pcb.
    [pcb_ledtorus_2.kicad_pcb]
2016-04-10 Final gerbers for rev1
    [pcb_ledtorus_2.kicad_pcb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]
